GauriK58/5-bit-Parallel-Prefix-Adder/media/FPGA2.jpg

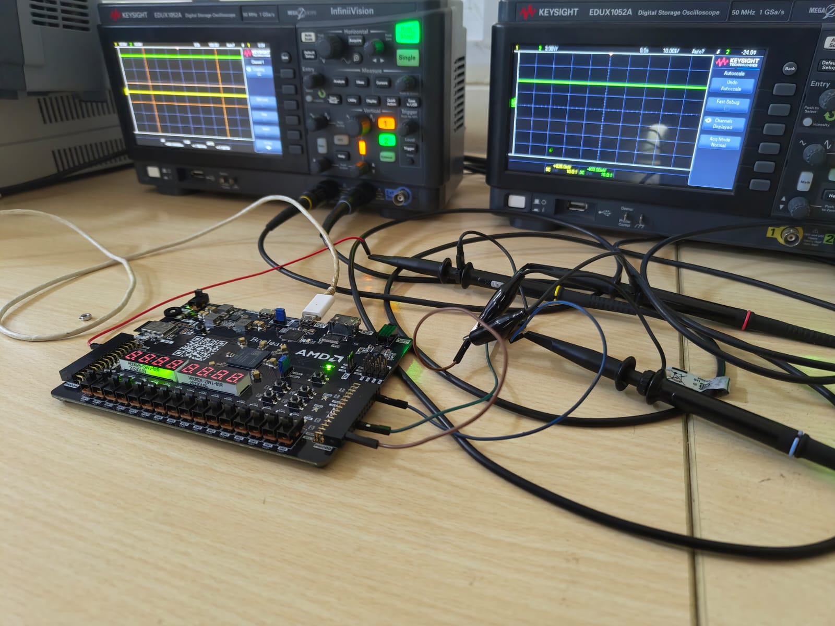
media/FPGA2.jpg
