GauriK58/5-bit-Parallel-Prefix-Adder/media/FPGA1.jpg

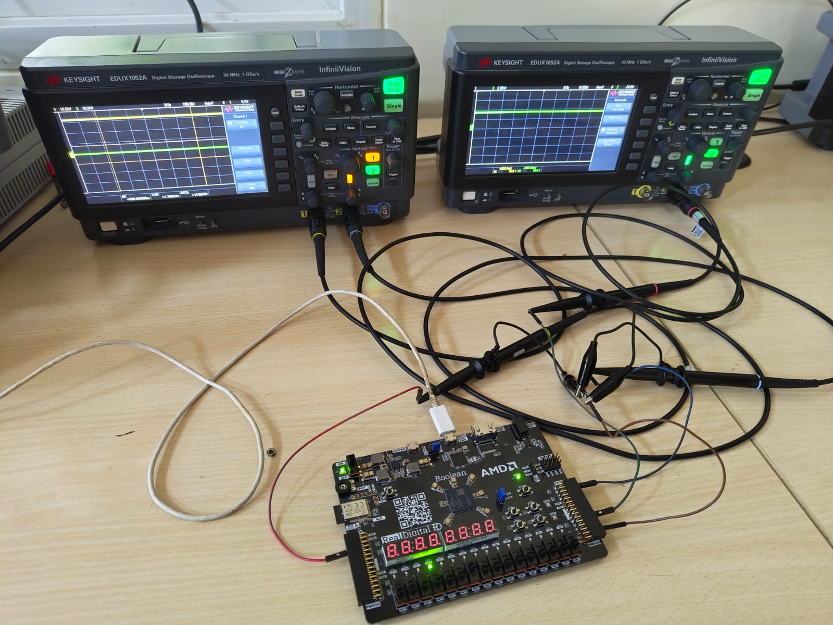
media/FPGA1.jpg
