GauriK58/5-bit-Parallel-Prefix-Adder/media/brentoperator.png

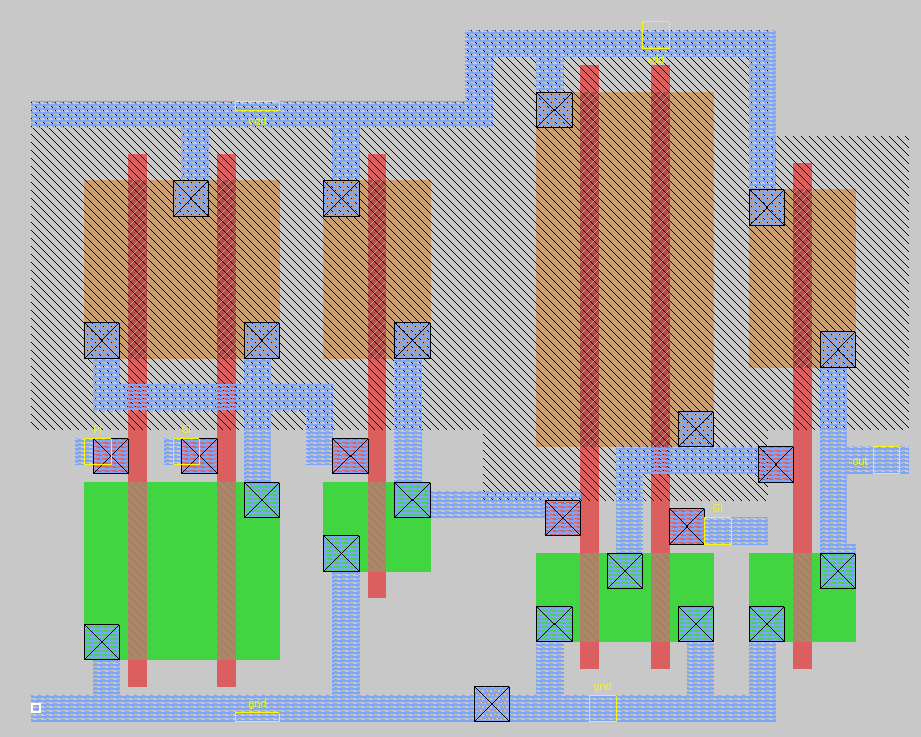
media/brentoperator.png
