GauriK58/5-bit-Parallel-Prefix-Adder/media/circuitdiagram.png

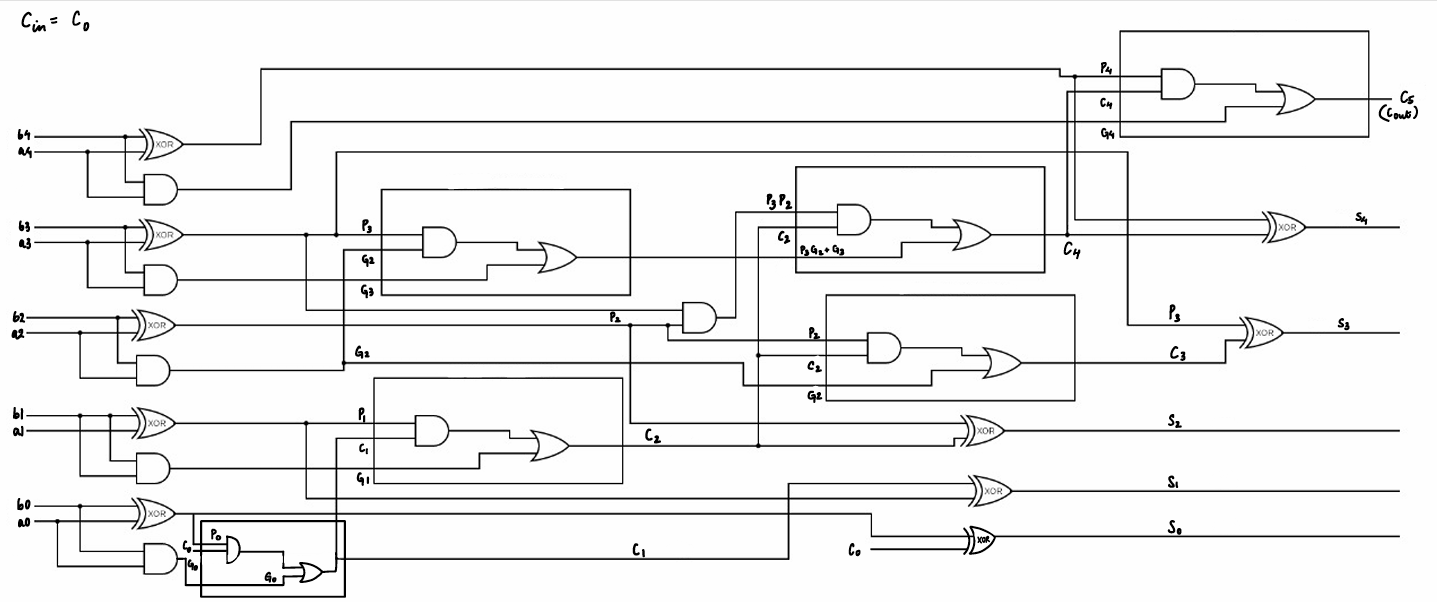
media/circuitdiagram.png
