GauriK58/5-bit-Parallel-Prefix-Adder/media/ip_op.png

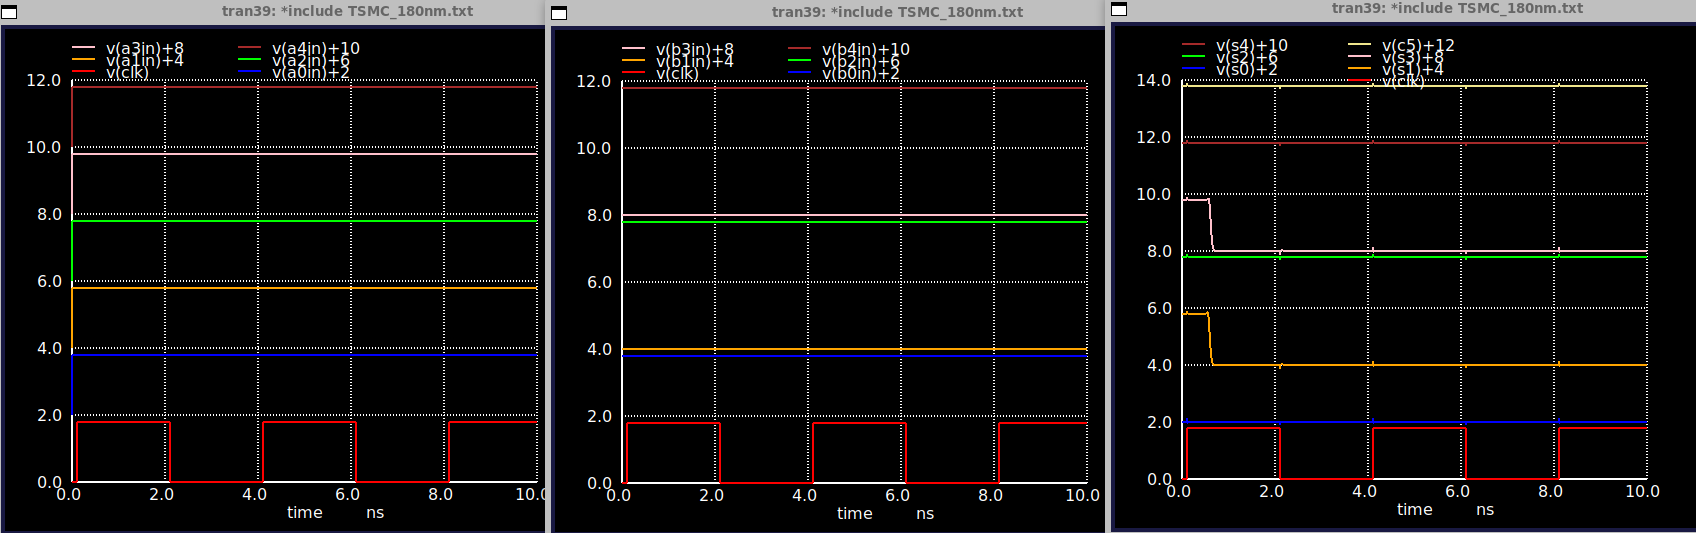
media/ip_op.png
