GauriK58/5-bit-Parallel-Prefix-Adder/media/ngspicepre1.png

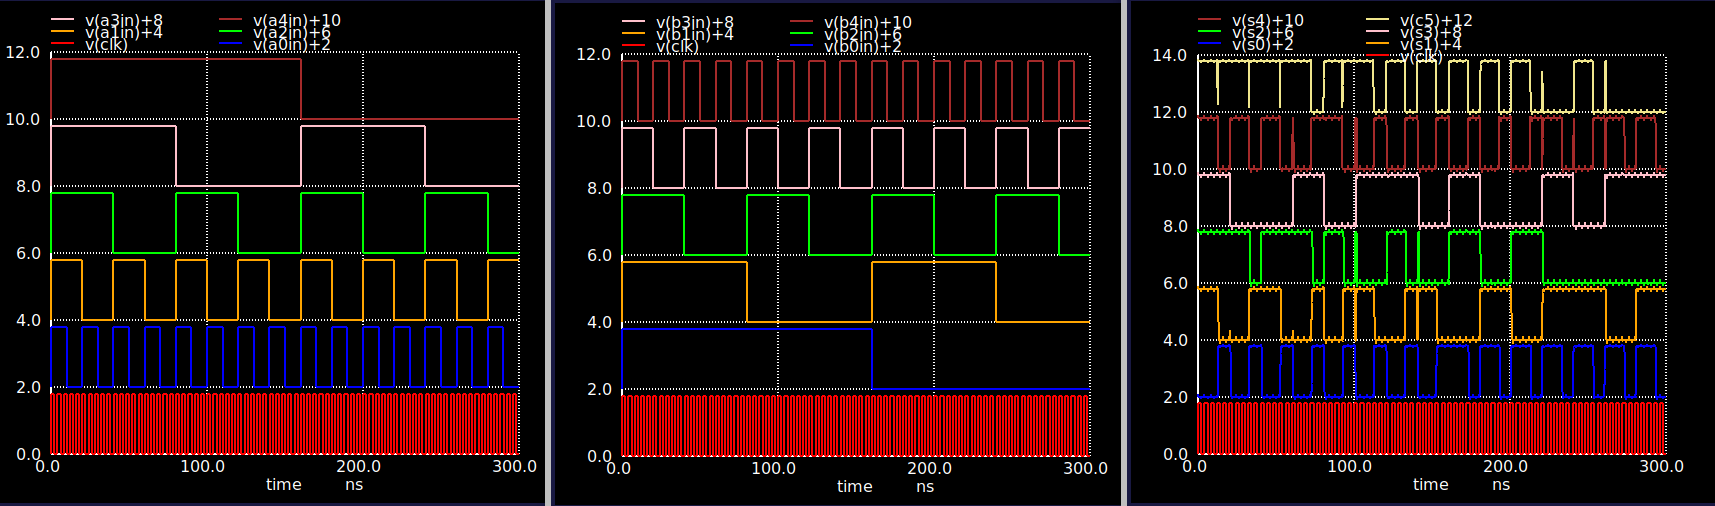
media/ngspicepre1.png
