GauriK58/5-bit-Parallel-Prefix-Adder/media/ngspicepre2.png

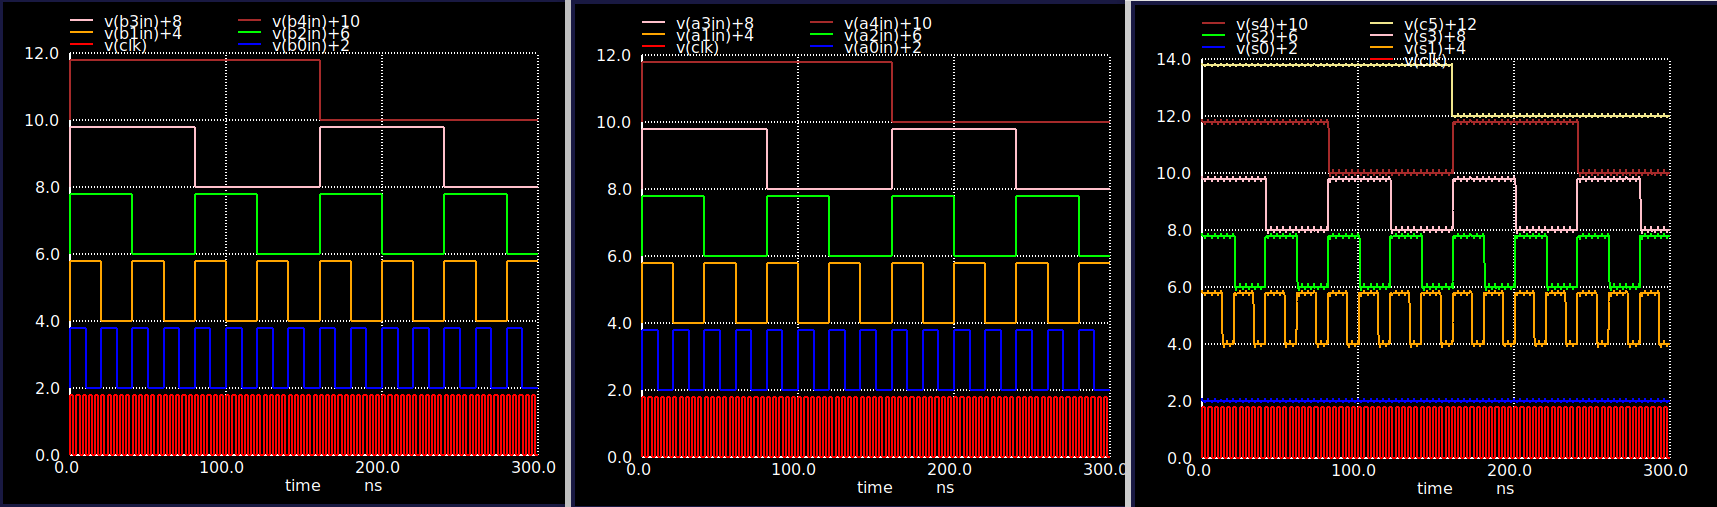
media/ngspicepre2.png
