GauriK58/5-bit-Parallel-Prefix-Adder/media/TSPC.png

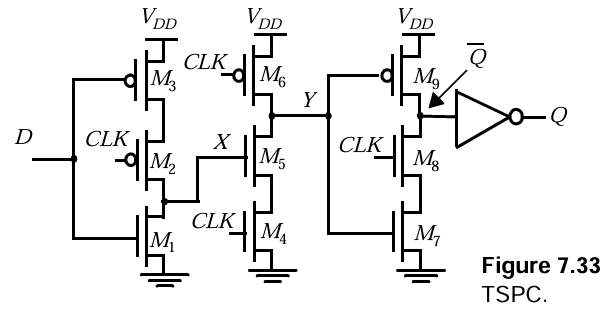
media/TSPC.png
