GauriK58/5-bit-Parallel-Prefix-Adder/ngspice/project_post.cir

.include TSMC_180nm.txt
.global gnd vdd

VDD vdd gnd dc 1.8V

* SPICE3 file created from project2.ext - technology: scmos

.option scale=0.09u

M1000 S2_ff a_536_362# VDD VDD CMOSP w=40 l=2
+  ad=200 pd=90 as=22922 ps=10400
M1001 b4 a_167_234# 0 0 CMOSN w=20 l=2
+  ad=100 pd=50 as=13032 ps=6526
M1002 a_306_571# a_296_604# a_306_519# VDD CMOSP w=32 l=2
+  ad=160 pd=74 as=192 ps=76
M1003 a_605_251# CLK VDD VDD CMOSP w=40 l=2
+  ad=200 pd=90 as=0 ps=0
M1004 0 G3 a_319_153# 0 CMOSN w=16 l=2
+  ad=0 pd=0 as=96 ps=44
M1005 0 CLK a_143_345# 0 CMOSN w=40 l=2
+  ad=0 pd=0 as=160 ps=88
M1006 a_13_419# a2_in 0 0 CMOSN w=20 l=2
+  ad=100 pd=50 as=0 ps=0
M1007 a_311_267# P3 0 0 CMOSN w=16 l=2
+  ad=96 pd=44 as=0 ps=0
M1008 a_505_512# CLK VDD VDD CMOSP w=40 l=2
+  ad=200 pd=90 as=0 ps=0
M1009 a_167_495# a_136_443# VDD VDD CMOSP w=40 l=2
+  ad=200 pd=90 as=0 ps=0
M1010 a_536_362# CLK a_536_414# 0 CMOSN w=40 l=2
+  ad=200 pd=90 as=160 ps=88
M1011 VDD P1 a_302_305# VDD CMOSP w=16 l=2
+  ad=0 pd=0 as=96 ps=44
M1012 a_43_443# a_13_419# a_36_443# 0 CMOSN w=40 l=2
+  ad=160 pd=88 as=200 ps=90
M1013 a_306_719# a_296_752# a_306_667# VDD CMOSP w=32 l=2
+  ad=160 pd=74 as=192 ps=76
M1014 a_306_719# G0 0 0 CMOSN w=8 l=2
+  ad=48 pd=28 as=0 ps=0
M1015 a_167_756# CLK a_167_704# 0 CMOSN w=40 l=2
+  ad=200 pd=90 as=160 ps=88
M1016 a_113_554# b1_in VDD VDD CMOSP w=80 l=2
+  ad=320 pd=168 as=0 ps=0
M1017 a_482_227# CLK a_482_263# VDD CMOSP w=80 l=2
+  ad=400 pd=170 as=320 ps=168
M1018 a_251_617# a_233_617# VDD VDD CMOSP w=16 l=2
+  ad=80 pd=42 as=0 ps=0
M1019 a_36_606# CLK VDD VDD CMOSP w=40 l=2
+  ad=200 pd=90 as=0 ps=0
M1020 a_536_251# a_505_251# 0 0 CMOSN w=40 l=2
+  ad=160 pd=88 as=0 ps=0
M1021 a_636_414# a_605_414# 0 0 CMOSN w=40 l=2
+  ad=160 pd=88 as=0 ps=0
M1022 0 a_360_99# a_370_66# 0 CMOSN w=8 l=2
+  ad=0 pd=0 as=48 ps=28
M1023 a_113_680# CLK a_113_716# VDD CMOSP w=80 l=2
+  ad=400 pd=170 as=320 ps=168
M1024 S4 a_414_553# 0 0 CMOSN w=8 l=2
+  ad=40 pd=26 as=0 ps=0
M1025 a_233_752# b0 a_208_752# 0 CMOSN w=8 l=2
+  ad=40 pd=26 as=80 ps=52
M1026 a4 a_67_234# VDD VDD CMOSP w=40 l=2
+  ad=280 pd=132 as=0 ps=0
M1027 S1_ff a_636_564# VDD VDD CMOSP w=40 l=2
+  ad=200 pd=90 as=0 ps=0
M1028 a_582_458# CLK a_582_362# VDD CMOSP w=80 l=2
+  ad=400 pd=170 as=320 ps=168
M1029 a_536_362# a_505_414# VDD VDD CMOSP w=40 l=2
+  ad=200 pd=90 as=0 ps=0
M1030 Cout_ff a_636_303# 0 0 CMOSN w=20 l=2
+  ad=100 pd=50 as=0 ps=0
M1031 VDD C1 a_366_337# VDD CMOSP w=17 l=2
+  ad=0 pd=0 as=102 ps=46
M1032 G2 a_226_411# VDD VDD CMOSP w=16 l=2
+  ad=80 pd=42 as=0 ps=0
M1033 a_396_752# a_378_752# VDD VDD CMOSP w=16 l=2
+  ad=80 pd=42 as=0 ps=0
M1034 a_113_419# b2_in 0 0 CMOSN w=20 l=2
+  ad=100 pd=50 as=0 ps=0
M1035 a_320_739# P0 a_301_749# 0 CMOSN w=16 l=2
+  ad=96 pd=44 as=80 ps=42
M1036 C4 a_370_214# 0 0 CMOSN w=8 l=2
+  ad=40 pd=26 as=0 ps=0
M1037 a_301_453# P2 VDD VDD CMOSP w=17 l=2
+  ad=102 pd=46 as=0 ps=0
M1038 C3 a_371_378# VDD VDD CMOSP w=16 l=2
+  ad=80 pd=42 as=0 ps=0
M1039 VDD a_302_305# P21 VDD CMOSP w=16 l=2
+  ad=0 pd=0 as=80 ps=42
M1040 a_689_299# Cout_ff a_680_388# w_676_315# CMOSP w=20 l=2
+  ad=100 pd=50 as=300 ps=150
M1041 a_143_443# a_113_419# a_136_443# 0 CMOSN w=40 l=2
+  ad=160 pd=88 as=200 ps=90
M1042 a_687_492# S0_ff VDD w_674_455# CMOSP w=20 l=2
+  ad=100 pd=50 as=0 ps=0
M1043 a_67_495# CLK a_67_443# 0 CMOSN w=40 l=2
+  ad=200 pd=90 as=160 ps=88
M1044 a_13_293# a3_in VDD VDD CMOSP w=80 l=2
+  ad=320 pd=168 as=0 ps=0
M1045 a_233_482# b2 a2 VDD CMOSP w=16 l=2
+  ad=80 pd=42 as=280 ps=132
M1046 VDD a2 a_226_411# VDD CMOSP w=16 l=2
+  ad=0 pd=0 as=96 ps=44
M1047 0 CLK a_512_251# 0 CMOSN w=40 l=2
+  ad=0 pd=0 as=160 ps=88
M1048 0 CLK a_612_414# 0 CMOSN w=40 l=2
+  ad=0 pd=0 as=160 ps=88
M1049 a_13_419# CLK a_13_455# VDD CMOSP w=80 l=2
+  ad=400 pd=170 as=320 ps=168
M1050 0 a_360_247# a_370_214# 0 CMOSN w=8 l=2
+  ad=0 pd=0 as=48 ps=28
M1051 a_136_606# CLK VDD VDD CMOSP w=40 l=2
+  ad=200 pd=90 as=0 ps=0
M1052 VDD a_301_453# a_296_456# VDD CMOSP w=17 l=2
+  ad=0 pd=0 as=85 ps=44
M1053 S0_ff a_536_564# 0 0 CMOSN w=20 l=2
+  ad=100 pd=50 as=0 ps=0
M1054 a_414_553# a_396_553# 0 0 CMOSN w=8 l=2
+  ad=40 pd=26 as=0 ps=0
M1055 a_687_439# S2_ff a_680_388# 0 CMOSN w=10 l=2
+  ad=50 pd=30 as=300 ps=180
M1056 0 a0 a_208_752# 0 CMOSN w=8 l=2
+  ad=0 pd=0 as=0 ps=0
M1057 a_67_234# a_36_182# VDD VDD CMOSP w=40 l=2
+  ad=200 pd=90 as=0 ps=0
M1058 a_636_564# a_605_512# VDD VDD CMOSP w=40 l=2
+  ad=200 pd=90 as=0 ps=0
M1059 a_300_163# P4 VDD VDD CMOSP w=17 l=2
+  ad=102 pd=46 as=0 ps=0
M1060 a_582_524# S1 VDD VDD CMOSP w=80 l=2
+  ad=320 pd=168 as=0 ps=0
M1061 b4 a_167_234# VDD VDD CMOSP w=40 l=2
+  ad=200 pd=90 as=0 ps=0
M1062 S3 a_407_622# VDD VDD CMOSP w=16 l=2
+  ad=80 pd=42 as=0 ps=0
M1063 G4 a_226_147# 0 0 CMOSN w=8 l=2
+  ad=40 pd=26 as=0 ps=0
M1064 a_226_448# b2 0 0 CMOSN w=16 l=2
+  ad=96 pd=44 as=0 ps=0
M1065 0 a_366_337# a_361_345# 0 CMOSN w=8 l=2
+  ad=0 pd=0 as=40 ps=26
M1066 a_378_752# C1 P1 VDD CMOSP w=16 l=2
+  ad=80 pd=42 as=160 ps=84
M1067 a_13_158# a4_in 0 0 CMOSN w=20 l=2
+  ad=100 pd=50 as=0 ps=0
M1068 S2_ff a_536_362# 0 0 CMOSN w=20 l=2
+  ad=100 pd=50 as=0 ps=0
M1069 a_371_378# a_361_345# a_371_406# VDD CMOSP w=32 l=2
+  ad=160 pd=74 as=192 ps=76
M1070 VDD a_300_163# a_295_166# VDD CMOSP w=17 l=2
+  ad=0 pd=0 as=85 ps=44
M1071 a_226_681# a0 a_226_718# 0 CMOSN w=16 l=2
+  ad=80 pd=42 as=96 ps=44
M1072 P4 a_251_218# 0 0 CMOSN w=8 l=2
+  ad=40 pd=26 as=0 ps=0
M1073 a_43_182# a_13_158# a_36_182# 0 CMOSN w=40 l=2
+  ad=160 pd=88 as=200 ps=90
M1074 C1 a_306_719# 0 0 CMOSN w=8 l=2
+  ad=40 pd=26 as=0 ps=0
M1075 VDD a2 a_208_482# VDD CMOSP w=16 l=2
+  ad=0 pd=0 as=80 ps=42
M1076 a_311_230# P4 a_311_267# 0 CMOSN w=16 l=2
+  ad=80 pd=42 as=0 ps=0
M1077 a_687_388# S3_ff a_680_388# 0 CMOSN w=10 l=2
+  ad=50 pd=30 as=0 ps=0
M1078 a_167_495# CLK a_167_443# 0 CMOSN w=40 l=2
+  ad=200 pd=90 as=160 ps=88
M1079 S2 a_404_687# 0 0 CMOSN w=8 l=2
+  ad=40 pd=26 as=0 ps=0
M1080 a_113_293# b3_in VDD VDD CMOSP w=80 l=2
+  ad=320 pd=168 as=0 ps=0
M1081 P3 a_251_350# VDD VDD CMOSP w=16 l=2
+  ad=160 pd=84 as=0 ps=0
M1082 a_67_704# a_36_704# 0 0 CMOSN w=40 l=2
+  ad=160 pd=88 as=0 ps=0
M1083 a_233_218# b4 a4 VDD CMOSP w=16 l=2
+  ad=80 pd=42 as=0 ps=0
M1084 a_36_345# CLK VDD VDD CMOSP w=40 l=2
+  ad=200 pd=90 as=0 ps=0
M1085 a_113_419# CLK a_113_455# VDD CMOSP w=80 l=2
+  ad=400 pd=170 as=320 ps=168
M1086 a_167_234# a_136_182# VDD VDD CMOSP w=40 l=2
+  ad=200 pd=90 as=0 ps=0
M1087 a_505_251# CLK VDD VDD CMOSP w=40 l=2
+  ad=200 pd=90 as=0 ps=0
M1088 a_233_482# b2 a_208_482# 0 CMOSN w=8 l=2
+  ad=40 pd=26 as=80 ps=52
M1089 a_407_622# a_389_622# VDD VDD CMOSP w=16 l=2
+  ad=80 pd=42 as=0 ps=0
M1090 a_384_234# P3 a_365_244# 0 CMOSN w=16 l=2
+  ad=96 pd=44 as=80 ps=42
M1091 0 a_296_752# a_306_719# 0 CMOSN w=8 l=2
+  ad=0 pd=0 as=0 ps=0
M1092 a_612_512# a_582_488# a_605_512# 0 CMOSN w=40 l=2
+  ad=160 pd=88 as=200 ps=90
M1093 a_396_752# a_378_752# 0 0 CMOSN w=8 l=2
+  ad=40 pd=26 as=0 ps=0
M1094 a_226_147# b4 VDD VDD CMOSP w=16 l=2
+  ad=96 pd=44 as=0 ps=0
M1095 a_43_606# a_13_650# a_36_606# 0 CMOSN w=40 l=2
+  ad=160 pd=88 as=200 ps=90
M1096 VDD P1 a_353_752# VDD CMOSP w=16 l=2
+  ad=0 pd=0 as=80 ps=42
M1097 a_226_184# b4 0 0 CMOSN w=16 l=2
+  ad=96 pd=44 as=0 ps=0
M1098 a_113_158# b4_in 0 0 CMOSN w=20 l=2
+  ad=100 pd=50 as=0 ps=0
M1099 S4 a_414_553# VDD VDD CMOSP w=16 l=2
+  ad=80 pd=42 as=0 ps=0
M1100 0 a_365_96# a_360_99# 0 CMOSN w=8 l=2
+  ad=0 pd=0 as=40 ps=26
M1101 a_251_218# a_233_218# 0 0 CMOSN w=8 l=2
+  ad=40 pd=26 as=0 ps=0
M1102 Cout_ff a_636_303# VDD VDD CMOSP w=40 l=2
+  ad=200 pd=90 as=0 ps=0
M1103 a_143_182# a_113_158# a_136_182# 0 CMOSN w=40 l=2
+  ad=160 pd=88 as=200 ps=90
M1104 a_305_133# a_295_166# a_305_81# VDD CMOSP w=32 l=2
+  ad=160 pd=74 as=192 ps=76
M1105 a_536_414# a_505_414# 0 0 CMOSN w=40 l=2
+  ad=0 pd=0 as=0 ps=0
M1106 a_67_234# CLK a_67_182# 0 CMOSN w=40 l=2
+  ad=200 pd=90 as=160 ps=88
M1107 0 a_302_305# P21 0 CMOSN w=8 l=2
+  ad=0 pd=0 as=40 ps=26
M1108 a_404_687# a_386_687# 0 0 CMOSN w=8 l=2
+  ad=40 pd=26 as=0 ps=0
M1109 a_251_350# a_233_350# VDD VDD CMOSP w=16 l=2
+  ad=80 pd=42 as=0 ps=0
M1110 S0_ff a_536_564# VDD VDD CMOSP w=40 l=2
+  ad=200 pd=90 as=0 ps=0
M1111 0 CLK a_43_704# 0 CMOSN w=40 l=2
+  ad=0 pd=0 as=160 ps=88
M1112 0 0 a_320_739# 0 CMOSN w=16 l=2
+  ad=0 pd=0 as=0 ps=0
M1113 VDD G1 a_301_453# VDD CMOSP w=17 l=2
+  ad=0 pd=0 as=0 ps=0
M1114 a_167_704# a_136_704# 0 0 CMOSN w=40 l=2
+  ad=0 pd=0 as=0 ps=0
M1115 VDD a4 a_208_218# VDD CMOSP w=16 l=2
+  ad=0 pd=0 as=80 ps=42
M1116 G34 a_305_133# VDD VDD CMOSP w=16 l=2
+  ad=80 pd=42 as=0 ps=0
M1117 a_482_458# CLK a_482_362# VDD CMOSP w=80 l=2
+  ad=400 pd=170 as=320 ps=168
M1118 a_13_158# CLK a_13_194# VDD CMOSP w=80 l=2
+  ad=400 pd=170 as=320 ps=168
M1119 S4_ff a_536_303# 0 0 CMOSN w=20 l=2
+  ad=100 pd=50 as=0 ps=0
M1120 a_136_345# CLK VDD VDD CMOSP w=40 l=2
+  ad=200 pd=90 as=0 ps=0
M1121 S3 a_407_622# 0 0 CMOSN w=8 l=2
+  ad=40 pd=26 as=0 ps=0
M1122 0 a2 a_208_482# 0 CMOSN w=8 l=2
+  ad=0 pd=0 as=0 ps=0
M1123 G1 a_226_546# 0 0 CMOSN w=8 l=2
+  ad=40 pd=26 as=0 ps=0
M1124 a_582_263# Cout VDD VDD CMOSP w=80 l=2
+  ad=320 pd=168 as=0 ps=0
M1125 a_687_544# S1_ff a_680_388# 0 CMOSN w=10 l=2
+  ad=50 pd=30 as=0 ps=0
M1126 a1 a_67_554# VDD VDD CMOSP w=40 l=2
+  ad=280 pd=132 as=0 ps=0
M1127 a_378_752# C1 a_353_752# 0 CMOSN w=8 l=2
+  ad=40 pd=26 as=80 ps=52
M1128 a_636_564# CLK a_636_512# 0 CMOSN w=40 l=2
+  ad=200 pd=90 as=160 ps=88
M1129 a_687_439# S2_ff VDD w_674_455# CMOSP w=20 l=2
+  ad=100 pd=50 as=0 ps=0
M1130 a_143_606# a_113_650# a_136_606# 0 CMOSN w=40 l=2
+  ad=160 pd=88 as=200 ps=90
M1131 a_582_458# S3 0 0 CMOSN w=20 l=2
+  ad=100 pd=50 as=0 ps=0
M1132 a_414_553# a_396_553# VDD VDD CMOSP w=16 l=2
+  ad=80 pd=42 as=0 ps=0
M1133 P1 a_251_617# 0 0 CMOSN w=8 l=2
+  ad=40 pd=26 as=0 ps=0
M1134 a_67_554# CLK a_67_606# 0 CMOSN w=40 l=2
+  ad=200 pd=90 as=160 ps=88
M1135 a_36_704# CLK VDD VDD CMOSP w=40 l=2
+  ad=200 pd=90 as=0 ps=0
M1136 VDD G3 a_300_163# VDD CMOSP w=17 l=2
+  ad=0 pd=0 as=0 ps=0
M1137 0 CLK a_512_414# 0 CMOSN w=40 l=2
+  ad=0 pd=0 as=160 ps=88
M1138 a_636_303# a_605_251# VDD VDD CMOSP w=40 l=2
+  ad=200 pd=90 as=0 ps=0
M1139 a_226_411# a2 a_226_448# 0 CMOSN w=16 l=2
+  ad=80 pd=42 as=0 ps=0
M1140 P3 a_251_350# 0 0 CMOSN w=8 l=2
+  ad=40 pd=26 as=0 ps=0
M1141 S2 a_404_687# VDD VDD CMOSP w=16 l=2
+  ad=80 pd=42 as=0 ps=0
M1142 a_233_617# b1 a1 VDD CMOSP w=16 l=2
+  ad=80 pd=42 as=0 ps=0
M1143 a_321_295# P2 a_302_305# 0 CMOSN w=16 l=2
+  ad=96 pd=44 as=80 ps=42
M1144 a_536_564# a_505_512# VDD VDD CMOSP w=40 l=2
+  ad=200 pd=90 as=0 ps=0
M1145 a_167_234# CLK a_167_182# 0 CMOSN w=40 l=2
+  ad=200 pd=90 as=160 ps=88
M1146 a_482_524# P0 VDD VDD CMOSP w=80 l=2
+  ad=320 pd=168 as=0 ps=0
M1147 a_67_443# a_36_443# 0 0 CMOSN w=40 l=2
+  ad=0 pd=0 as=0 ps=0
M1148 G3 a_226_279# 0 0 CMOSN w=8 l=2
+  ad=40 pd=26 as=0 ps=0
M1149 0 CLK a_143_704# 0 CMOSN w=40 l=2
+  ad=0 pd=0 as=160 ps=88
M1150 a_407_622# a_389_622# 0 0 CMOSN w=8 l=2
+  ad=40 pd=26 as=0 ps=0
M1151 a_13_650# CLK a_13_554# VDD CMOSP w=80 l=2
+  ad=400 pd=170 as=320 ps=168
M1152 a_113_158# CLK a_113_194# VDD CMOSP w=80 l=2
+  ad=400 pd=170 as=320 ps=168
M1153 a_226_546# b1 VDD VDD CMOSP w=16 l=2
+  ad=96 pd=44 as=0 ps=0
M1154 a_301_601# P1 VDD VDD CMOSP w=17 l=2
+  ad=102 pd=46 as=0 ps=0
M1155 a_67_554# a_36_606# VDD VDD CMOSP w=40 l=2
+  ad=200 pd=90 as=0 ps=0
M1156 a_612_251# a_582_227# a_605_251# 0 CMOSN w=40 l=2
+  ad=160 pd=88 as=200 ps=90
M1157 G4 a_226_147# VDD VDD CMOSP w=16 l=2
+  ad=80 pd=42 as=0 ps=0
M1158 0 P1 a_353_752# 0 CMOSN w=8 l=2
+  ad=0 pd=0 as=0 ps=0
M1159 a_226_583# b1 0 0 CMOSN w=16 l=2
+  ad=96 pd=44 as=0 ps=0
M1160 a_582_488# S1 0 0 CMOSN w=20 l=2
+  ad=100 pd=50 as=0 ps=0
M1161 b1 a_167_554# VDD VDD CMOSP w=40 l=2
+  ad=200 pd=90 as=0 ps=0
M1162 a_43_345# a_13_389# a_36_345# 0 CMOSN w=40 l=2
+  ad=160 pd=88 as=200 ps=90
M1163 a_251_617# a_233_617# 0 0 CMOSN w=8 l=2
+  ad=40 pd=26 as=0 ps=0
M1164 a_605_414# CLK VDD VDD CMOSP w=40 l=2
+  ad=200 pd=90 as=0 ps=0
M1165 a_136_704# CLK VDD VDD CMOSP w=40 l=2
+  ad=200 pd=90 as=0 ps=0
M1166 a_167_554# CLK a_167_606# 0 CMOSN w=40 l=2
+  ad=200 pd=90 as=160 ps=88
M1167 a_13_650# a1_in 0 0 CMOSN w=20 l=2
+  ad=100 pd=50 as=0 ps=0
M1168 0 C3 a_384_234# 0 CMOSN w=16 l=2
+  ad=0 pd=0 as=0 ps=0
M1169 a_301_749# P0 VDD VDD CMOSP w=17 l=2
+  ad=102 pd=46 as=0 ps=0
M1170 P0 a_251_752# VDD VDD CMOSP w=16 l=2
+  ad=80 pd=42 as=0 ps=0
M1171 a_384_86# P34 a_365_96# 0 CMOSN w=16 l=2
+  ad=96 pd=44 as=80 ps=42
M1172 VDD a_301_601# a_296_604# VDD CMOSP w=17 l=2
+  ad=0 pd=0 as=85 ps=44
M1173 a_689_247# S4_ff a_680_388# 0 CMOSN w=10 l=2
+  ad=50 pd=30 as=0 ps=0
M1174 VDD a4 a_226_147# VDD CMOSP w=16 l=2
+  ad=0 pd=0 as=0 ps=0
M1175 a_251_350# a_233_350# 0 0 CMOSN w=8 l=2
+  ad=40 pd=26 as=0 ps=0
M1176 a_404_687# a_386_687# VDD VDD CMOSP w=16 l=2
+  ad=80 pd=42 as=0 ps=0
M1177 VDD a1 a_208_617# VDD CMOSP w=16 l=2
+  ad=0 pd=0 as=80 ps=42
M1178 a_226_147# a4 a_226_184# 0 CMOSN w=16 l=2
+  ad=80 pd=42 as=0 ps=0
M1179 a_396_553# C4 a_371_553# 0 CMOSN w=8 l=2
+  ad=40 pd=26 as=80 ps=52
M1180 0 CLK a_43_443# 0 CMOSN w=40 l=2
+  ad=0 pd=0 as=0 ps=0
M1181 a_167_443# a_136_443# 0 0 CMOSN w=40 l=2
+  ad=0 pd=0 as=0 ps=0
M1182 a_512_512# a_482_488# a_505_512# 0 CMOSN w=40 l=2
+  ad=160 pd=88 as=200 ps=90
M1183 a0 a_67_756# 0 0 CMOSN w=20 l=2
+  ad=100 pd=50 as=0 ps=0
M1184 a_13_716# a0_in VDD VDD CMOSP w=80 l=2
+  ad=320 pd=168 as=0 ps=0
M1185 a_370_14# G34 VDD VDD CMOSP w=32 l=2
+  ad=192 pd=76 as=0 ps=0
M1186 VDD a_301_749# a_296_752# VDD CMOSP w=17 l=2
+  ad=0 pd=0 as=85 ps=44
M1187 a_113_650# CLK a_113_554# VDD CMOSP w=80 l=2
+  ad=400 pd=170 as=0 ps=0
M1188 a3 a_67_293# VDD VDD CMOSP w=40 l=2
+  ad=280 pd=132 as=0 ps=0
M1189 C2 a_306_571# VDD VDD CMOSP w=16 l=2
+  ad=80 pd=42 as=0 ps=0
M1190 a_167_554# a_136_606# VDD VDD CMOSP w=40 l=2
+  ad=200 pd=90 as=0 ps=0
M1191 a_636_303# CLK a_636_251# 0 CMOSN w=40 l=2
+  ad=200 pd=90 as=160 ps=88
M1192 a1 a_67_554# 0 0 CMOSN w=20 l=2
+  ad=100 pd=50 as=0 ps=0
M1193 a_13_680# a0_in 0 0 CMOSN w=20 l=2
+  ad=100 pd=50 as=0 ps=0
M1194 S4_ff a_536_303# VDD VDD CMOSP w=40 l=2
+  ad=200 pd=90 as=0 ps=0
M1195 a_143_345# a_113_389# a_136_345# 0 CMOSN w=40 l=2
+  ad=0 pd=0 as=200 ps=90
M1196 a_36_443# CLK VDD VDD CMOSP w=40 l=2
+  ad=200 pd=90 as=0 ps=0
M1197 a_67_293# CLK a_67_345# 0 CMOSN w=40 l=2
+  ad=200 pd=90 as=160 ps=88
M1198 a_251_752# a_233_752# VDD VDD CMOSP w=16 l=2
+  ad=80 pd=42 as=0 ps=0
M1199 a_113_650# b1_in 0 0 CMOSN w=20 l=2
+  ad=100 pd=50 as=0 ps=0
M1200 C1 a_306_719# VDD VDD CMOSP w=16 l=2
+  ad=80 pd=42 as=0 ps=0
M1201 a_371_378# G21 0 0 CMOSN w=8 l=2
+  ad=48 pd=28 as=0 ps=0
M1202 a_385_350# P21 a_366_337# 0 CMOSN w=16 l=2
+  ad=96 pd=44 as=80 ps=42
M1203 0 P4 a_371_553# 0 CMOSN w=8 l=2
+  ad=0 pd=0 as=0 ps=0
M1204 a_482_263# S4 VDD VDD CMOSP w=80 l=2
+  ad=0 pd=0 as=0 ps=0
M1205 a_365_96# P34 VDD VDD CMOSP w=17 l=2
+  ad=102 pd=46 as=0 ps=0
M1206 a_67_182# a_36_182# 0 0 CMOSN w=40 l=2
+  ad=0 pd=0 as=0 ps=0
M1207 0 CLK a_143_443# 0 CMOSN w=40 l=2
+  ad=0 pd=0 as=0 ps=0
M1208 a_389_622# C3 P3 VDD CMOSP w=16 l=2
+  ad=80 pd=42 as=0 ps=0
M1209 b0 a_167_756# 0 0 CMOSN w=20 l=2
+  ad=100 pd=50 as=0 ps=0
M1210 a_113_716# b0_in VDD VDD CMOSP w=80 l=2
+  ad=0 pd=0 as=0 ps=0
M1211 a_13_389# CLK a_13_293# VDD CMOSP w=80 l=2
+  ad=400 pd=170 as=0 ps=0
M1212 G1 a_226_546# VDD VDD CMOSP w=16 l=2
+  ad=80 pd=42 as=0 ps=0
M1213 0 a_301_453# a_296_456# 0 CMOSN w=8 l=2
+  ad=0 pd=0 as=40 ps=26
M1214 a_536_564# CLK a_536_512# 0 CMOSN w=40 l=2
+  ad=200 pd=90 as=160 ps=88
M1215 a_482_458# S2 0 0 CMOSN w=20 l=2
+  ad=100 pd=50 as=0 ps=0
M1216 a_582_362# S3 VDD VDD CMOSP w=80 l=2
+  ad=0 pd=0 as=0 ps=0
M1217 0 P1 a_321_295# 0 CMOSN w=16 l=2
+  ad=0 pd=0 as=0 ps=0
M1218 a_67_293# a_36_345# VDD VDD CMOSP w=40 l=2
+  ad=200 pd=90 as=0 ps=0
M1219 a_365_244# P3 VDD VDD CMOSP w=17 l=2
+  ad=102 pd=46 as=0 ps=0
M1220 b3 a_167_293# VDD VDD CMOSP w=40 l=2
+  ad=200 pd=90 as=0 ps=0
M1221 Cout a_370_66# 0 0 CMOSN w=8 l=2
+  ad=40 pd=26 as=0 ps=0
M1222 a_582_488# CLK a_582_524# VDD CMOSP w=80 l=2
+  ad=400 pd=170 as=0 ps=0
M1223 a_536_303# a_505_251# VDD VDD CMOSP w=40 l=2
+  ad=200 pd=90 as=0 ps=0
M1224 VDD a_365_96# a_360_99# VDD CMOSP w=17 l=2
+  ad=0 pd=0 as=85 ps=44
M1225 a_687_388# S3_ff a_680_388# w_674_382# CMOSP w=20 l=2
+  ad=100 pd=50 as=0 ps=0
M1226 b1 a_167_554# 0 0 CMOSN w=20 l=2
+  ad=100 pd=50 as=0 ps=0
M1227 a_113_680# b0_in 0 0 CMOSN w=20 l=2
+  ad=100 pd=50 as=0 ps=0
M1228 a_636_512# a_605_512# 0 0 CMOSN w=40 l=2
+  ad=0 pd=0 as=0 ps=0
M1229 P0 a_251_752# 0 0 CMOSN w=8 l=2
+  ad=40 pd=26 as=0 ps=0
M1230 Cout a_370_66# VDD VDD CMOSP w=16 l=2
+  ad=80 pd=42 as=0 ps=0
M1231 a_233_218# b4 a_208_218# 0 CMOSN w=8 l=2
+  ad=40 pd=26 as=80 ps=52
M1232 a_136_443# CLK VDD VDD CMOSP w=40 l=2
+  ad=200 pd=90 as=0 ps=0
M1233 a_167_293# CLK a_167_345# 0 CMOSN w=40 l=2
+  ad=200 pd=90 as=160 ps=88
M1234 VDD a1 a_226_546# VDD CMOSP w=16 l=2
+  ad=0 pd=0 as=0 ps=0
M1235 VDD C1 a_301_601# VDD CMOSP w=17 l=2
+  ad=0 pd=0 as=0 ps=0
M1236 a_67_606# a_36_606# 0 0 CMOSN w=40 l=2
+  ad=0 pd=0 as=0 ps=0
M1237 a_386_687# C2 a_361_687# 0 CMOSN w=8 l=2
+  ad=40 pd=26 as=80 ps=52
M1238 G0 a_226_681# 0 0 CMOSN w=8 l=2
+  ad=40 pd=26 as=0 ps=0
M1239 a_226_546# a1 a_226_583# 0 CMOSN w=16 l=2
+  ad=80 pd=42 as=0 ps=0
M1240 0 a_300_163# a_295_166# 0 CMOSN w=8 l=2
+  ad=0 pd=0 as=40 ps=26
M1241 a_233_350# b3 a3 VDD CMOSP w=16 l=2
+  ad=80 pd=42 as=0 ps=0
M1242 a0 a_67_756# VDD VDD CMOSP w=40 l=2
+  ad=280 pd=132 as=0 ps=0
M1243 VDD a_365_244# a_360_247# VDD CMOSP w=17 l=2
+  ad=0 pd=0 as=85 ps=44
M1244 a_582_227# Cout 0 0 CMOSN w=20 l=2
+  ad=100 pd=50 as=0 ps=0
M1245 a_370_66# G34 0 0 CMOSN w=8 l=2
+  ad=0 pd=0 as=0 ps=0
M1246 0 CLK a_43_182# 0 CMOSN w=40 l=2
+  ad=0 pd=0 as=0 ps=0
M1247 VDD P3 a_364_622# VDD CMOSP w=16 l=2
+  ad=0 pd=0 as=80 ps=42
M1248 a_512_251# a_482_227# a_505_251# 0 CMOSN w=40 l=2
+  ad=0 pd=0 as=200 ps=90
M1249 a_167_182# a_136_182# 0 0 CMOSN w=40 l=2
+  ad=0 pd=0 as=0 ps=0
M1250 a_612_414# a_582_458# a_605_414# 0 CMOSN w=40 l=2
+  ad=0 pd=0 as=200 ps=90
M1251 a2 a_67_495# 0 0 CMOSN w=20 l=2
+  ad=100 pd=50 as=0 ps=0
M1252 a_306_423# G2 0 0 CMOSN w=8 l=2
+  ad=48 pd=28 as=0 ps=0
M1253 VDD 0 a_301_749# VDD CMOSP w=17 l=2
+  ad=0 pd=0 as=0 ps=0
M1254 a_482_488# P0 0 0 CMOSN w=20 l=2
+  ad=100 pd=50 as=0 ps=0
M1255 a_13_455# a2_in VDD VDD CMOSP w=80 l=2
+  ad=0 pd=0 as=0 ps=0
M1256 0 a_301_601# a_296_604# 0 CMOSN w=8 l=2
+  ad=0 pd=0 as=40 ps=26
M1257 a_113_389# CLK a_113_293# VDD CMOSP w=80 l=2
+  ad=400 pd=170 as=0 ps=0
M1258 a_226_279# b3 VDD VDD CMOSP w=16 l=2
+  ad=96 pd=44 as=0 ps=0
M1259 a_226_681# b0 VDD VDD CMOSP w=16 l=2
+  ad=96 pd=44 as=0 ps=0
M1260 a_689_247# S4_ff a_680_388# w_676_240# CMOSP w=20 l=2
+  ad=100 pd=50 as=0 ps=0
M1261 C4 a_370_214# VDD VDD CMOSP w=16 l=2
+  ad=80 pd=42 as=0 ps=0
M1262 P2 a_251_482# VDD VDD CMOSP w=16 l=2
+  ad=160 pd=84 as=0 ps=0
M1263 a_167_293# a_136_345# VDD VDD CMOSP w=40 l=2
+  ad=200 pd=90 as=0 ps=0
M1264 a_396_553# C4 P4 VDD CMOSP w=16 l=2
+  ad=80 pd=42 as=160 ps=84
M1265 a_505_414# CLK VDD VDD CMOSP w=40 l=2
+  ad=200 pd=90 as=0 ps=0
M1266 a3 a_67_293# 0 0 CMOSN w=20 l=2
+  ad=100 pd=50 as=0 ps=0
M1267 a_306_571# G1 0 0 CMOSN w=8 l=2
+  ad=48 pd=28 as=0 ps=0
M1268 a_370_162# G3 VDD VDD CMOSP w=32 l=2
+  ad=192 pd=76 as=0 ps=0
M1269 0 CLK a_612_512# 0 CMOSN w=40 l=2
+  ad=0 pd=0 as=0 ps=0
M1270 0 a_301_749# a_296_752# 0 CMOSN w=8 l=2
+  ad=0 pd=0 as=40 ps=26
M1271 a_251_752# a_233_752# 0 0 CMOSN w=8 l=2
+  ad=40 pd=26 as=0 ps=0
M1272 0 a4 a_208_218# 0 CMOSN w=8 l=2
+  ad=0 pd=0 as=0 ps=0
M1273 a_305_133# G4 0 0 CMOSN w=8 l=2
+  ad=48 pd=28 as=0 ps=0
M1274 C3 a_371_378# 0 0 CMOSN w=8 l=2
+  ad=40 pd=26 as=0 ps=0
M1275 0 CLK a_43_606# 0 CMOSN w=40 l=2
+  ad=0 pd=0 as=0 ps=0
M1276 0 P2 a_361_687# 0 CMOSN w=8 l=2
+  ad=0 pd=0 as=0 ps=0
M1277 a_320_443# P2 a_301_453# 0 CMOSN w=16 l=2
+  ad=96 pd=44 as=80 ps=42
M1278 a_167_606# a_136_606# 0 0 CMOSN w=40 l=2
+  ad=0 pd=0 as=0 ps=0
M1279 VDD a3 a_208_350# VDD CMOSP w=16 l=2
+  ad=0 pd=0 as=80 ps=42
M1280 a_226_316# b3 0 0 CMOSN w=16 l=2
+  ad=96 pd=44 as=0 ps=0
M1281 a_67_756# a_36_704# VDD VDD CMOSP w=40 l=2
+  ad=200 pd=90 as=0 ps=0
M1282 G21 a_306_423# VDD VDD CMOSP w=17 l=2
+  ad=85 pd=44 as=0 ps=0
M1283 S3_ff a_636_362# VDD VDD CMOSP w=40 l=2
+  ad=200 pd=90 as=0 ps=0
M1284 a_389_622# C3 a_364_622# 0 CMOSN w=8 l=2
+  ad=40 pd=26 as=80 ps=52
M1285 b0 a_167_756# VDD VDD CMOSP w=40 l=2
+  ad=200 pd=90 as=0 ps=0
M1286 S1 a_396_752# VDD VDD CMOSP w=16 l=2
+  ad=80 pd=42 as=0 ps=0
M1287 a_311_230# P3 VDD VDD CMOSP w=16 l=2
+  ad=96 pd=44 as=0 ps=0
M1288 0 CLK a_143_182# 0 CMOSN w=40 l=2
+  ad=0 pd=0 as=0 ps=0
M1289 b2 a_167_495# 0 0 CMOSN w=20 l=2
+  ad=100 pd=50 as=0 ps=0
M1290 a_306_370# G2 VDD VDD CMOSP w=33 l=2
+  ad=198 pd=78 as=0 ps=0
M1291 a_113_455# b2_in VDD VDD CMOSP w=80 l=2
+  ad=0 pd=0 as=0 ps=0
M1292 a_320_591# P1 a_301_601# 0 CMOSN w=16 l=2
+  ad=96 pd=44 as=80 ps=42
M1293 0 a_361_345# a_371_378# 0 CMOSN w=8 l=2
+  ad=0 pd=0 as=0 ps=0
M1294 a_605_512# CLK VDD VDD CMOSP w=40 l=2
+  ad=200 pd=90 as=0 ps=0
M1295 a_36_182# CLK VDD VDD CMOSP w=40 l=2
+  ad=200 pd=90 as=0 ps=0
M1296 a_636_362# CLK a_636_414# 0 CMOSN w=40 l=2
+  ad=200 pd=90 as=0 ps=0
M1297 a_536_303# CLK a_536_251# 0 CMOSN w=40 l=2
+  ad=200 pd=90 as=0 ps=0
M1298 0 C1 a_385_350# 0 CMOSN w=16 l=2
+  ad=0 pd=0 as=0 ps=0
M1299 a_251_482# a_233_482# VDD VDD CMOSP w=16 l=2
+  ad=80 pd=42 as=0 ps=0
M1300 a_687_544# S1_ff VDD w_674_560# CMOSP w=20 l=2
+  ad=100 pd=50 as=0 ps=0
M1301 a_306_519# G1 VDD VDD CMOSP w=32 l=2
+  ad=0 pd=0 as=0 ps=0
M1302 VDD P4 a_371_553# VDD CMOSP w=16 l=2
+  ad=0 pd=0 as=80 ps=42
M1303 a_319_153# P4 a_300_163# 0 CMOSN w=16 l=2
+  ad=0 pd=0 as=80 ps=42
M1304 VDD C4 a_365_96# VDD CMOSP w=17 l=2
+  ad=0 pd=0 as=0 ps=0
M1305 P4 a_251_218# VDD VDD CMOSP w=16 l=2
+  ad=0 pd=0 as=0 ps=0
M1306 a_233_617# b1 a_208_617# 0 CMOSN w=8 l=2
+  ad=40 pd=26 as=80 ps=52
M1307 a_582_227# CLK a_582_263# VDD CMOSP w=80 l=2
+  ad=400 pd=170 as=0 ps=0
M1308 b3 a_167_293# 0 0 CMOSN w=20 l=2
+  ad=100 pd=50 as=0 ps=0
M1309 a_636_251# a_605_251# 0 0 CMOSN w=40 l=2
+  ad=0 pd=0 as=0 ps=0
M1310 a_302_305# P2 VDD VDD CMOSP w=16 l=2
+  ad=0 pd=0 as=0 ps=0
M1311 P2 a_251_482# 0 0 CMOSN w=8 l=2
+  ad=40 pd=26 as=0 ps=0
M1312 a_386_687# C2 P2 VDD CMOSP w=16 l=2
+  ad=80 pd=42 as=0 ps=0
M1313 a_233_350# b3 a_208_350# 0 CMOSN w=8 l=2
+  ad=40 pd=26 as=80 ps=52
M1314 a_67_345# a_36_345# 0 0 CMOSN w=40 l=2
+  ad=0 pd=0 as=0 ps=0
M1315 a_306_667# G0 VDD VDD CMOSP w=32 l=2
+  ad=0 pd=0 as=0 ps=0
M1316 0 CLK a_143_606# 0 CMOSN w=40 l=2
+  ad=0 pd=0 as=0 ps=0
M1317 G2 a_226_411# 0 0 CMOSN w=8 l=2
+  ad=40 pd=26 as=0 ps=0
M1318 VDD C3 a_365_244# VDD CMOSP w=17 l=2
+  ad=0 pd=0 as=0 ps=0
M1319 a_636_362# a_605_414# VDD VDD CMOSP w=40 l=2
+  ad=200 pd=90 as=0 ps=0
M1320 a2 a_67_495# VDD VDD CMOSP w=40 l=2
+  ad=0 pd=0 as=0 ps=0
M1321 0 P3 a_364_622# 0 CMOSN w=8 l=2
+  ad=0 pd=0 as=0 ps=0
M1322 a_167_756# a_136_704# VDD VDD CMOSP w=40 l=2
+  ad=200 pd=90 as=0 ps=0
M1323 a_43_704# a_13_680# a_36_704# 0 CMOSN w=40 l=2
+  ad=0 pd=0 as=200 ps=90
M1324 G21 a_306_423# 0 0 CMOSN w=8 l=2
+  ad=40 pd=26 as=0 ps=0
M1325 0 a_365_244# a_360_247# 0 CMOSN w=8 l=2
+  ad=0 pd=0 as=40 ps=26
M1326 a_482_362# S2 VDD VDD CMOSP w=80 l=2
+  ad=0 pd=0 as=0 ps=0
M1327 0 C4 a_384_86# 0 CMOSN w=16 l=2
+  ad=0 pd=0 as=0 ps=0
M1328 a_689_299# Cout_ff a_680_388# 0 CMOSN w=10 l=2
+  ad=50 pd=30 as=0 ps=0
M1329 a_13_194# a4_in VDD VDD CMOSP w=80 l=2
+  ad=0 pd=0 as=0 ps=0
M1330 G3 a_226_279# VDD VDD CMOSP w=16 l=2
+  ad=80 pd=42 as=0 ps=0
M1331 G0 a_226_681# VDD VDD CMOSP w=16 l=2
+  ad=80 pd=42 as=0 ps=0
M1332 a_482_488# CLK a_482_524# VDD CMOSP w=80 l=2
+  ad=400 pd=170 as=0 ps=0
M1333 a_136_182# CLK VDD VDD CMOSP w=40 l=2
+  ad=200 pd=90 as=0 ps=0
M1334 a_366_337# P21 VDD VDD CMOSP w=17 l=2
+  ad=0 pd=0 as=0 ps=0
M1335 a_536_512# a_505_512# 0 0 CMOSN w=40 l=2
+  ad=0 pd=0 as=0 ps=0
M1336 a_13_389# a3_in 0 0 CMOSN w=20 l=2
+  ad=100 pd=50 as=0 ps=0
M1337 C2 a_306_571# 0 0 CMOSN w=8 l=2
+  ad=40 pd=26 as=0 ps=0
M1338 a_251_218# a_233_218# VDD VDD CMOSP w=16 l=2
+  ad=80 pd=42 as=0 ps=0
M1339 0 a1 a_208_617# 0 CMOSN w=8 l=2
+  ad=0 pd=0 as=0 ps=0
M1340 0 a_296_456# a_306_423# 0 CMOSN w=8 l=2
+  ad=0 pd=0 as=0 ps=0
M1341 a_370_66# a_360_99# a_370_14# VDD CMOSP w=32 l=2
+  ad=160 pd=74 as=0 ps=0
M1342 0 CLK a_612_251# 0 CMOSN w=40 l=2
+  ad=0 pd=0 as=0 ps=0
M1343 a_251_482# a_233_482# 0 0 CMOSN w=8 l=2
+  ad=40 pd=26 as=0 ps=0
M1344 VDD P2 a_361_687# VDD CMOSP w=16 l=2
+  ad=0 pd=0 as=80 ps=42
M1345 a_233_752# b0 a0 VDD CMOSP w=16 l=2
+  ad=80 pd=42 as=0 ps=0
M1346 G34 a_305_133# 0 0 CMOSN w=8 l=2
+  ad=40 pd=26 as=0 ps=0
M1347 VDD a3 a_226_279# VDD CMOSP w=16 l=2
+  ad=0 pd=0 as=0 ps=0
M1348 S1_ff a_636_564# 0 0 CMOSN w=20 l=2
+  ad=100 pd=50 as=0 ps=0
M1349 a4 a_67_234# 0 0 CMOSN w=20 l=2
+  ad=100 pd=50 as=0 ps=0
M1350 VDD a0 a_226_681# VDD CMOSP w=16 l=2
+  ad=0 pd=0 as=0 ps=0
M1351 a_305_81# G4 VDD VDD CMOSP w=32 l=2
+  ad=0 pd=0 as=0 ps=0
M1352 0 a3 a_208_350# 0 CMOSN w=8 l=2
+  ad=0 pd=0 as=0 ps=0
M1353 a_482_227# S4 0 0 CMOSN w=20 l=2
+  ad=100 pd=50 as=0 ps=0
M1354 0 CLK a_43_345# 0 CMOSN w=40 l=2
+  ad=0 pd=0 as=0 ps=0
M1355 VDD a_366_337# a_361_345# VDD CMOSP w=17 l=2
+  ad=0 pd=0 as=85 ps=44
M1356 a_512_414# a_482_458# a_505_414# 0 CMOSN w=40 l=2
+  ad=0 pd=0 as=200 ps=90
M1357 a_167_345# a_136_345# 0 0 CMOSN w=40 l=2
+  ad=0 pd=0 as=0 ps=0
M1358 S1 a_396_752# 0 0 CMOSN w=8 l=2
+  ad=40 pd=26 as=0 ps=0
M1359 a_226_411# b2 VDD VDD CMOSP w=16 l=2
+  ad=0 pd=0 as=0 ps=0
M1360 P34 a_311_230# 0 0 CMOSN w=8 l=2
+  ad=40 pd=26 as=0 ps=0
M1361 a_67_495# a_36_443# VDD VDD CMOSP w=40 l=2
+  ad=200 pd=90 as=0 ps=0
M1362 0 a_296_604# a_306_571# 0 CMOSN w=8 l=2
+  ad=0 pd=0 as=0 ps=0
M1363 P34 a_311_230# VDD VDD CMOSP w=16 l=2
+  ad=80 pd=42 as=0 ps=0
M1364 a_370_214# a_360_247# a_370_162# VDD CMOSP w=32 l=2
+  ad=160 pd=74 as=0 ps=0
M1365 b2 a_167_495# VDD VDD CMOSP w=40 l=2
+  ad=200 pd=90 as=0 ps=0
M1366 a_370_214# G3 0 0 CMOSN w=8 l=2
+  ad=0 pd=0 as=0 ps=0
M1367 a_143_704# a_113_680# a_136_704# 0 CMOSN w=40 l=2
+  ad=0 pd=0 as=200 ps=90
M1368 S3_ff a_636_362# 0 0 CMOSN w=20 l=2
+  ad=100 pd=50 as=0 ps=0
M1369 0 a_295_166# a_305_133# 0 CMOSN w=8 l=2
+  ad=0 pd=0 as=0 ps=0
M1370 a_67_756# CLK a_67_704# 0 CMOSN w=40 l=2
+  ad=200 pd=90 as=0 ps=0
M1371 0 G1 a_320_443# 0 CMOSN w=16 l=2
+  ad=0 pd=0 as=0 ps=0
M1372 a_13_554# a1_in VDD VDD CMOSP w=80 l=2
+  ad=0 pd=0 as=0 ps=0
M1373 a_113_194# b4_in VDD VDD CMOSP w=80 l=2
+  ad=0 pd=0 as=0 ps=0
M1374 a_687_492# S0_ff a_680_388# 0 CMOSN w=10 l=2
+  ad=50 pd=30 as=0 ps=0
M1375 a_226_279# a3 a_226_316# 0 CMOSN w=16 l=2
+  ad=80 pd=42 as=0 ps=0
M1376 0 CLK a_512_512# 0 CMOSN w=40 l=2
+  ad=0 pd=0 as=0 ps=0
M1377 P1 a_251_617# VDD VDD CMOSP w=16 l=2
+  ad=0 pd=0 as=0 ps=0
M1378 a_13_680# CLK a_13_716# VDD CMOSP w=80 l=2
+  ad=400 pd=170 as=0 ps=0
M1379 VDD P4 a_311_230# VDD CMOSP w=16 l=2
+  ad=0 pd=0 as=0 ps=0
M1380 a_113_389# b3_in 0 0 CMOSN w=20 l=2
+  ad=100 pd=50 as=0 ps=0
M1381 a_371_406# G21 VDD VDD CMOSP w=32 l=2
+  ad=0 pd=0 as=0 ps=0
M1382 a_306_423# a_296_456# a_306_370# VDD CMOSP w=33 l=2
+  ad=165 pd=76 as=0 ps=0
M1383 0 C1 a_320_591# 0 CMOSN w=16 l=2
+  ad=0 pd=0 as=0 ps=0
M1384 VDD a0 a_208_752# VDD CMOSP w=16 l=2
+  ad=0 pd=0 as=80 ps=42
M1385 a_226_718# b0 0 0 CMOSN w=16 l=2
+  ad=0 pd=0 as=0 ps=0
C0 S1 S2 0.46fF
C1 a_113_650# a1 0.10fF
C2 a_378_752# 0 0.01fF
C3 a_301_453# 0 0.05fF
C4 C3 VDD 0.80fF
C5 CLK a1_in 0.10fF
C6 a0 a_136_704# 0.22fF
C7 0 a_582_458# 0.05fF
C8 CLK a_136_345# 0.10fF
C9 a_13_419# VDD 0.04fF
C10 a_582_227# S4_ff 0.10fF
C11 VDD S3_ff 0.04fF
C12 Cout CLK 0.18fF
C13 a2_in CLK 0.10fF
C14 a_167_182# a4 0.02fF
C15 a_505_512# CLK 0.10fF
C16 a_167_345# a3 0.02fF
C17 G34 P34 0.02fF
C18 a4 a_113_158# 0.10fF
C19 G1 P1 0.07fF
C20 VDD b1_in 0.13fF
C21 VDD a_36_345# 0.17fF
C22 P1 C1 0.76fF
C23 P0 a_378_752# 0.09fF
C24 G21 VDD 0.18fF
C25 a_113_194# a4 0.02fF
C26 VDD a_306_423# 0.11fF
C27 0 a_251_218# 0.02fF
C28 a_167_182# 0 0.00fF
C29 S3 a_482_458# 0.00fF
C30 S3 CLK 0.18fF
C31 a_67_293# VDD 0.13fF
C32 VDD S4_ff 0.14fF
C33 a_208_350# VDD 0.02fF
C34 0 a_113_158# 0.06fF
C35 S2_ff a_536_362# 0.03fF
C36 a_36_443# a_67_495# 0.02fF
C37 a0 a_233_752# 0.09fF
C38 a_167_234# b4 0.03fF
C39 P21 a_361_345# 1.02fF
C40 a_360_247# a_370_214# 0.27fF
C41 a_605_414# S2_ff 0.22fF
C42 a_364_622# a_389_622# 0.08fF
C43 a_233_482# 0 0.01fF
C44 P1 a_353_752# 0.48fF
C45 0 a_371_378# 0.07fF
C46 a_320_591# C2 0.01fF
C47 a_370_214# C4 0.08fF
C48 a_360_247# 0 0.22fF
C49 a_167_293# a_136_345# 0.02fF
C50 a_251_350# 0 0.02fF
C51 P21 P2 0.10fF
C52 a_167_443# 0 0.00fF
C53 VDD a_296_604# 0.22fF
C54 a4_in VDD 0.10fF
C55 b3 a3 1.00fF
C56 C4 0 0.44fF
C57 a_233_350# a_251_350# 0.05fF
C58 a_536_303# S4_ff 0.03fF
C59 0 a_370_66# 0.05fF
C60 0 a_226_681# 0.05fF
C61 0 S1 0.09fF
C62 VDD a_208_752# 0.02fF
C63 0 G4 0.05fF
C64 a_296_456# P2 0.18fF
C65 a_680_388# w_674_382# 0.11fF
C66 a_365_244# 0 0.05fF
C67 0 a_226_184# 0.00fF
C68 b2 a2 0.90fF
C69 0 a2 0.22fF
C70 CLK a_505_414# 0.10fF
C71 P1 0 0.69fF
C72 a_636_303# S4_ff 0.15fF
C73 a_113_419# a2 0.10fF
C74 a_208_617# VDD 0.02fF
C75 a_482_362# S3 0.00fF
C76 a_233_617# 0 0.01fF
C77 a4 a_167_234# 0.15fF
C78 a_296_604# a_306_571# 0.27fF
C79 a_295_166# G4 0.43fF
C80 0 a_361_687# 0.02fF
C81 P1 C2 0.13fF
C82 a4 b4_in 0.08fF
C83 a_582_227# VDD 0.04fF
C84 P0 S1 0.17fF
C85 VDD a_386_687# 0.09fF
C86 b2 a_208_482# 0.08fF
C87 a_208_482# 0 0.02fF
C88 a_233_482# a_251_482# 0.05fF
C89 VDD a_320_443# 0.00fF
C90 0 a0_in 0.02fF
C91 b2_in a2 0.08fF
C92 C2 a_361_687# 0.01fF
C93 a3 a_226_279# 0.22fF
C94 0 a_167_234# 0.01fF
C95 a_360_247# G3 0.43fF
C96 CLK a_136_182# 0.10fF
C97 P0 P1 0.78fF
C98 a_680_388# w_676_240# 0.11fF
C99 0 b4_in 0.02fF
C100 a_636_512# S0_ff 0.02fF
C101 a_13_650# CLK 0.42fF
C102 a_361_345# C1 0.64fF
C103 G1 P2 0.51fF
C104 S2_ff a_612_414# 0.02fF
C105 a_13_680# VDD 0.04fF
C106 P4 P34 0.23fF
C107 G4 G3 0.04fF
C108 G2 P1 0.07fF
C109 a3 CLK 0.23fF
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
