GauriK58/5-bit-Parallel-Prefix-Adder/magic/project.spice

* SPICE3 file created from project.ext - technology: scmos

.option scale=0.09u

M1000 a_265_644# C4 a_272_609# Gnd nfet w=20 l=2
+  ad=100 pd=50 as=180 ps=58
M1001 a_391_202# a_389_191# a_379_170# Gnd nfet w=10 l=2
+  ad=50 pd=30 as=60 ps=32
M1002 a_42_93# CLK vdd vdd pfet w=20 l=2
+  ad=100 pd=50 as=12980 ps=6018
M1003 a_285_89# P0 gnd Gnd nfet w=20 l=2
+  ad=180 pd=58 as=6700 ps=3800
M1004 a_231_450# B3 a_219_418# Gnd nfet w=10 l=2
+  ad=50 pd=30 as=60 ps=32
M1005 a_149_448# a_119_472# a_142_448# Gnd nfet w=20 l=2
+  ad=80 pd=48 as=100 ps=50
M1006 a_379_170# C2 gnd Gnd nfet w=10 l=2
+  ad=0 pd=0 as=0 ps=0
M1007 a_71_416# a_42_448# vdd vdd pfet w=20 l=2
+  ad=100 pd=50 as=0 ps=0
M1008 a_19_416# B3in vdd vdd pfet w=40 l=2
+  ad=160 pd=88 as=0 ps=0
M1009 A3 a_171_416# vdd vdd pfet w=20 l=2
+  ad=200 pd=100 as=0 ps=0
M1010 G2 a_212_288# gnd Gnd nfet w=10 l=2
+  ad=50 pd=30 as=0 ps=0
M1011 a_171_160# CLK a_171_192# Gnd nfet w=10 l=2
+  ad=50 pd=30 as=40 ps=28
M1012 a_219_66# B0 gnd Gnd nfet w=20 l=2
+  ad=160 pd=56 as=0 ps=0
M1013 a_231_101# B0 A0 vdd pfet w=20 l=2
+  ad=100 pd=50 as=200 ps=100
M1014 a_308_11# a_288_44# gnd Gnd nfet w=10 l=2
+  ad=50 pd=30 as=0 ps=0
M1015 A3 a_171_416# gnd Gnd nfet w=10 l=2
+  ad=50 pd=30 as=0 ps=0
M1016 a_219_418# A3 gnd Gnd nfet w=10 l=2
+  ad=0 pd=0 as=0 ps=0
M1017 a_171_381# CLK a_171_359# Gnd nfet w=10 l=2
+  ad=50 pd=30 as=40 ps=28
M1018 gnd CLK a_49_192# Gnd nfet w=20 l=2
+  ad=0 pd=0 as=80 ps=48
M1019 B0 a_71_125# vdd vdd pfet w=20 l=2
+  ad=100 pd=50 as=0 ps=0
M1020 a_251_162# a_231_194# gnd Gnd nfet w=10 l=2
+  ad=50 pd=30 as=0 ps=0
M1021 G2 a_212_288# vdd w_206_245# pfet w=20 l=2
+  ad=100 pd=50 as=0 ps=0
M1022 vdd a_264_283# a_267_278# w_294_255# pfet w=20 l=2
+  ad=0 pd=0 as=200 ps=100
M1023 a_212_253# A1 a_219_219# Gnd nfet w=20 l=2
+  ad=100 pd=50 as=160 ps=56
M1024 a_212_637# A4 a_219_603# Gnd nfet w=20 l=2
+  ad=100 pd=50 as=160 ps=56
M1025 a_19_361# B2in vdd vdd pfet w=40 l=2
+  ad=160 pd=88 as=0 ps=0
M1026 a_142_93# CLK vdd vdd pfet w=20 l=2
+  ad=100 pd=50 as=0 ps=0
M1027 a_315_160# a_281_160# vdd vdd pfet w=20 l=2
+  ad=100 pd=50 as=0 ps=0
M1028 a_19_335# B2in gnd Gnd nfet w=10 l=2
+  ad=50 pd=30 as=0 ps=0
M1029 a_310_357# a_276_381# vdd vdd pfet w=20 l=2
+  ad=100 pd=50 as=0 ps=0
M1030 a_313_416# a_279_416# gnd Gnd nfet w=10 l=2
+  ad=50 pd=30 as=0 ps=0
M1031 a_119_79# A0in gnd Gnd nfet w=10 l=2
+  ad=50 pd=30 as=0 ps=0
M1032 a_231_194# B1 A1 vdd pfet w=20 l=2
+  ad=100 pd=50 as=200 ps=100
M1033 a_299_619# a_265_644# vdd w_206_629# pfet w=20 l=2
+  ad=100 pd=50 as=0 ps=0
M1034 G3 a_212_509# vdd vdd pfet w=20 l=2
+  ad=100 pd=50 as=0 ps=0
M1035 C3 a_334_341# vdd vdd pfet w=20 l=2
+  ad=200 pd=100 as=0 ps=0
M1036 a_376_109# C1 vdd vdd pfet w=20 l=2
+  ad=100 pd=50 as=0 ps=0
M1037 a_171_416# a_142_448# vdd vdd pfet w=20 l=2
+  ad=100 pd=50 as=0 ps=0
M1038 a_411_170# a_391_202# gnd Gnd nfet w=10 l=2
+  ad=50 pd=30 as=0 ps=0
M1039 a_287_578# P3P2 gnd Gnd nfet w=20 l=2
+  ad=160 pd=56 as=0 ps=0
M1040 a_119_416# A3in vdd vdd pfet w=40 l=2
+  ad=160 pd=88 as=0 ps=0
M1041 a_386_348# a_384_343# a_374_370# Gnd nfet w=10 l=2
+  ad=50 pd=30 as=60 ps=32
M1042 a_336_85# G0 a_336_107# vdd pfet w=40 l=2
+  ad=200 pd=90 as=240 ps=92
M1043 a_71_125# a_42_93# vdd vdd pfet w=20 l=2
+  ad=100 pd=50 as=0 ps=0
M1044 gnd CLK a_149_192# Gnd nfet w=20 l=2
+  ad=0 pd=0 as=80 ps=48
M1045 A0 a_171_125# vdd vdd pfet w=20 l=2
+  ad=0 pd=0 as=0 ps=0
M1046 a_219_379# A2 vdd vdd pfet w=20 l=2
+  ad=100 pd=50 as=0 ps=0
M1047 a_276_381# C2 a_283_347# Gnd nfet w=20 l=2
+  ad=100 pd=50 as=160 ps=56
M1048 a_374_370# C3 vdd vdd pfet w=20 l=2
+  ad=100 pd=50 as=0 ps=0
M1049 a_281_160# C1 vdd vdd pfet w=20 l=2
+  ad=200 pd=100 as=0 ps=0
M1050 gnd G4 a_323_619# Gnd nfet w=10 l=2
+  ad=0 pd=0 as=60 ps=32
M1051 a_119_361# A2in vdd vdd pfet w=40 l=2
+  ad=160 pd=88 as=0 ps=0
M1052 a_219_322# B2 gnd Gnd nfet w=20 l=2
+  ad=160 pd=56 as=0 ps=0
M1053 P2 a_251_357# vdd vdd pfet w=20 l=2
+  ad=100 pd=50 as=0 ps=0
M1054 a_19_216# CLK a_19_160# vdd pfet w=40 l=2
+  ad=200 pd=90 as=160 ps=88
M1055 a_410_556# a_390_588# vdd vdd pfet w=20 l=2
+  ad=100 pd=50 as=0 ps=0
M1056 a_337_414# a_313_416# vdd vdd pfet w=40 l=2
+  ad=240 pd=92 as=0 ps=0
M1057 a_119_335# A2in gnd Gnd nfet w=10 l=2
+  ad=50 pd=30 as=0 ps=0
M1058 P0 a_251_101# gnd Gnd nfet w=10 l=2
+  ad=50 pd=30 as=0 ps=0
M1059 a_313_416# a_279_416# vdd vdd pfet w=20 l=2
+  ad=100 pd=50 as=0 ps=0
M1060 vdd B2 a_212_288# w_206_245# pfet w=20 l=2
+  ad=0 pd=0 as=200 ps=100
M1061 a_71_544# CLK a_71_576# Gnd nfet w=10 l=2
+  ad=50 pd=30 as=40 ps=28
M1062 a_279_416# G2 a_286_450# Gnd nfet w=20 l=2
+  ad=100 pd=50 as=160 ps=56
M1063 a_251_101# a_231_101# vdd vdd pfet w=20 l=2
+  ad=100 pd=50 as=0 ps=0
M1064 a_323_619# a_299_619# gnd Gnd nfet w=10 l=2
+  ad=0 pd=0 as=0 ps=0
M1065 a_71_192# a_42_192# gnd Gnd nfet w=10 l=2
+  ad=40 pd=28 as=0 ps=0
M1066 G3 a_212_509# gnd Gnd nfet w=10 l=2
+  ad=50 pd=30 as=0 ps=0
M1067 a_49_93# a_19_79# a_42_93# Gnd nfet w=20 l=2
+  ad=80 pd=48 as=100 ps=50
M1068 a_71_359# a_42_349# gnd Gnd nfet w=10 l=2
+  ad=40 pd=28 as=0 ps=0
M1069 a_171_125# a_142_93# vdd vdd pfet w=20 l=2
+  ad=100 pd=50 as=0 ps=0
M1070 vdd B3 a_212_509# vdd pfet w=20 l=2
+  ad=0 pd=0 as=200 ps=100
M1071 a_315_160# a_281_160# gnd Gnd nfet w=10 l=2
+  ad=50 pd=30 as=0 ps=0
M1072 gnd CLK a_49_93# Gnd nfet w=20 l=2
+  ad=0 pd=0 as=0 ps=0
M1073 a_390_588# a_388_577# C4 vdd pfet w=20 l=2
+  ad=100 pd=50 as=200 ps=100
M1074 a_279_416# G2 vdd vdd pfet w=20 l=2
+  ad=200 pd=100 as=0 ps=0
M1075 a_119_216# CLK a_119_160# vdd pfet w=40 l=2
+  ad=200 pd=90 as=160 ps=88
M1076 a_42_192# CLK vdd vdd pfet w=20 l=2
+  ad=100 pd=50 as=0 ps=0
M1077 a_251_162# a_231_194# vdd vdd pfet w=20 l=2
+  ad=100 pd=50 as=0 ps=0
M1078 a_219_418# A3 vdd vdd pfet w=20 l=2
+  ad=100 pd=50 as=0 ps=0
M1079 a_42_349# CLK vdd vdd pfet w=20 l=2
+  ad=100 pd=50 as=0 ps=0
M1080 a_339_210# a_315_160# gnd Gnd nfet w=10 l=2
+  ad=60 pd=32 as=0 ps=0
M1081 a_171_544# CLK a_171_576# Gnd nfet w=10 l=2
+  ad=50 pd=30 as=40 ps=28
M1082 a_406_348# a_386_348# gnd Gnd nfet w=10 l=2
+  ad=50 pd=30 as=0 ps=0
M1083 a_411_170# a_391_202# vdd vdd pfet w=20 l=2
+  ad=100 pd=50 as=0 ps=0
M1084 P3 a_251_418# vdd vdd pfet w=20 l=2
+  ad=100 pd=50 as=0 ps=0
M1085 a_251_357# a_231_357# gnd Gnd nfet w=10 l=2
+  ad=50 pd=30 as=0 ps=0
M1086 a_334_341# a_310_357# gnd Gnd nfet w=10 l=2
+  ad=60 pd=32 as=0 ps=0
M1087 a_288_44# C0 a_276_11# Gnd nfet w=10 l=2
+  ad=50 pd=30 as=60 ps=32
M1088 gnd CLK a_49_576# Gnd nfet w=20 l=2
+  ad=0 pd=0 as=80 ps=48
M1089 a_251_546# a_231_578# gnd Gnd nfet w=10 l=2
+  ad=50 pd=30 as=0 ps=0
M1090 C1 a_336_85# vdd vdd pfet w=20 l=2
+  ad=200 pd=100 as=0 ps=0
M1091 a_171_192# a_142_192# gnd Gnd nfet w=10 l=2
+  ad=0 pd=0 as=0 ps=0
M1092 a_339_158# a_315_160# vdd vdd pfet w=40 l=2
+  ad=240 pd=92 as=0 ps=0
M1093 a_386_348# a_384_343# C3 vdd pfet w=20 l=2
+  ad=100 pd=50 as=0 ps=0
M1094 a_171_359# a_142_349# gnd Gnd nfet w=10 l=2
+  ad=0 pd=0 as=0 ps=0
M1095 a_49_192# a_19_216# a_42_192# Gnd nfet w=20 l=2
+  ad=0 pd=0 as=100 ps=50
M1096 C2 a_339_210# vdd vdd pfet w=20 l=2
+  ad=200 pd=100 as=0 ps=0
M1097 a_281_160# C1 a_288_194# Gnd nfet w=20 l=2
+  ad=100 pd=50 as=160 ps=56
M1098 a_337_466# a_313_416# gnd Gnd nfet w=10 l=2
+  ad=60 pd=32 as=0 ps=0
M1099 a_212_253# A1 vdd w_206_245# pfet w=20 l=2
+  ad=200 pd=100 as=0 ps=0
M1100 B1 a_71_160# vdd vdd pfet w=20 l=2
+  ad=100 pd=50 as=0 ps=0
M1101 S0 a_308_11# vdd w_263_0# pfet w=20 l=2
+  ad=100 pd=50 as=0 ps=0
M1102 a_231_101# B0 a_219_123# Gnd nfet w=10 l=2
+  ad=50 pd=30 as=60 ps=32
M1103 a_231_578# B4 A4 vdd pfet w=20 l=2
+  ad=100 pd=50 as=200 ps=100
M1104 B2 a_71_381# vdd vdd pfet w=20 l=2
+  ad=100 pd=50 as=0 ps=0
M1105 a_219_603# B4 gnd Gnd nfet w=20 l=2
+  ad=0 pd=0 as=0 ps=0
M1106 a_212_509# A3 a_219_475# Gnd nfet w=20 l=2
+  ad=100 pd=50 as=160 ps=56
M1107 B1 a_71_160# gnd Gnd nfet w=10 l=2
+  ad=50 pd=30 as=0 ps=0
M1108 a_219_219# B1 gnd Gnd nfet w=20 l=2
+  ad=0 pd=0 as=0 ps=0
M1109 S1 a_408_87# gnd Gnd nfet w=10 l=2
+  ad=50 pd=30 as=0 ps=0
M1110 a_278_125# C0 vdd vdd pfet w=20 l=2
+  ad=200 pd=100 as=0 ps=0
M1111 a_142_192# CLK vdd vdd pfet w=20 l=2
+  ad=100 pd=50 as=0 ps=0
M1112 a_323_619# G4 a_323_641# w_206_629# pfet w=40 l=2
+  ad=200 pd=90 as=240 ps=92
M1113 C4 a_338_594# gnd Gnd nfet w=10 l=2
+  ad=50 pd=30 as=0 ps=0
M1114 gnd CLK a_49_349# Gnd nfet w=20 l=2
+  ad=0 pd=0 as=80 ps=48
M1115 a_142_349# CLK vdd vdd pfet w=20 l=2
+  ad=100 pd=50 as=0 ps=0
M1116 a_391_202# a_389_191# C2 vdd pfet w=20 l=2
+  ad=100 pd=50 as=0 ps=0
M1117 S4 a_410_556# gnd Gnd nfet w=10 l=2
+  ad=50 pd=30 as=0 ps=0
M1118 B2 a_71_381# gnd Gnd nfet w=10 l=2
+  ad=50 pd=30 as=0 ps=0
M1119 a_336_85# a_312_101# gnd Gnd nfet w=10 l=2
+  ad=60 pd=32 as=0 ps=0
M1120 a_337_466# G3 a_337_414# vdd pfet w=40 l=2
+  ad=200 pd=90 as=0 ps=0
M1121 gnd CLK a_149_576# Gnd nfet w=20 l=2
+  ad=0 pd=0 as=80 ps=48
M1122 a_219_123# A0 gnd Gnd nfet w=10 l=2
+  ad=0 pd=0 as=0 ps=0
M1123 a_251_418# a_231_450# gnd Gnd nfet w=10 l=2
+  ad=50 pd=30 as=0 ps=0
M1124 a_71_125# CLK a_71_103# Gnd nfet w=10 l=2
+  ad=50 pd=30 as=40 ps=28
M1125 a_323_641# a_299_619# vdd w_206_629# pfet w=40 l=2
+  ad=0 pd=0 as=0 ps=0
M1126 a_19_600# CLK a_19_544# vdd pfet w=40 l=2
+  ad=200 pd=90 as=160 ps=88
M1127 a_149_192# a_119_216# a_142_192# Gnd nfet w=20 l=2
+  ad=0 pd=0 as=100 ps=50
M1128 a_19_216# B1in gnd Gnd nfet w=10 l=2
+  ad=50 pd=30 as=0 ps=0
M1129 a_19_600# B4in gnd Gnd nfet w=10 l=2
+  ad=50 pd=30 as=0 ps=0
M1130 a_71_160# a_42_192# vdd vdd pfet w=20 l=2
+  ad=100 pd=50 as=0 ps=0
M1131 a_71_381# a_42_349# vdd vdd pfet w=20 l=2
+  ad=100 pd=50 as=0 ps=0
M1132 a_276_381# C2 vdd vdd pfet w=20 l=2
+  ad=200 pd=100 as=0 ps=0
M1133 a_267_278# a_264_294# vdd w_294_255# pfet w=20 l=2
+  ad=0 pd=0 as=0 ps=0
M1134 a_19_160# B1in vdd vdd pfet w=40 l=2
+  ad=0 pd=0 as=0 ps=0
M1135 A1 a_171_160# vdd vdd pfet w=20 l=2
+  ad=0 pd=0 as=0 ps=0
M1136 A2 a_171_381# vdd vdd pfet w=20 l=2
+  ad=200 pd=100 as=0 ps=0
M1137 a_283_347# P2 gnd Gnd nfet w=20 l=2
+  ad=0 pd=0 as=0 ps=0
M1138 a_408_87# a_388_87# vdd vdd pfet w=20 l=2
+  ad=100 pd=50 as=0 ps=0
M1139 a_376_109# C1 gnd Gnd nfet w=10 l=2
+  ad=60 pd=32 as=0 ps=0
M1140 vdd P1 a_281_160# vdd pfet w=20 l=2
+  ad=0 pd=0 as=0 ps=0
M1141 A1 a_171_160# gnd Gnd nfet w=10 l=2
+  ad=50 pd=30 as=0 ps=0
M1142 a_71_576# a_42_576# gnd Gnd nfet w=10 l=2
+  ad=0 pd=0 as=0 ps=0
M1143 gnd CLK a_149_349# Gnd nfet w=20 l=2
+  ad=0 pd=0 as=80 ps=48
M1144 A2 a_171_381# gnd Gnd nfet w=10 l=2
+  ad=50 pd=30 as=0 ps=0
M1145 P1 a_251_162# gnd Gnd nfet w=10 l=2
+  ad=50 pd=30 as=0 ps=0
M1146 a_19_79# CLK a_19_105# vdd pfet w=40 l=2
+  ad=200 pd=90 as=160 ps=88
M1147 a_286_450# P3 gnd Gnd nfet w=20 l=2
+  ad=0 pd=0 as=0 ps=0
M1148 gnd G1 a_339_210# Gnd nfet w=10 l=2
+  ad=0 pd=0 as=0 ps=0
M1149 a_406_348# a_386_348# vdd vdd pfet w=20 l=2
+  ad=100 pd=50 as=0 ps=0
M1150 a_288_44# C0 P0 w_263_0# pfet w=20 l=2
+  ad=100 pd=50 as=200 ps=100
M1151 vdd a_265_630# a_265_644# w_206_629# pfet w=20 l=2
+  ad=0 pd=0 as=200 ps=100
M1152 a_119_600# CLK a_119_544# vdd pfet w=40 l=2
+  ad=200 pd=90 as=160 ps=88
M1153 a_310_357# a_276_381# gnd Gnd nfet w=10 l=2
+  ad=50 pd=30 as=0 ps=0
M1154 gnd G2 a_334_341# Gnd nfet w=10 l=2
+  ad=0 pd=0 as=0 ps=0
M1155 a_171_125# CLK a_171_103# Gnd nfet w=10 l=2
+  ad=50 pd=30 as=40 ps=28
M1156 G1 a_212_253# vdd w_206_245# pfet w=20 l=2
+  ad=100 pd=50 as=0 ps=0
M1157 a_272_609# a_265_630# gnd Gnd nfet w=20 l=2
+  ad=0 pd=0 as=0 ps=0
M1158 a_42_576# CLK vdd vdd pfet w=20 l=2
+  ad=100 pd=50 as=0 ps=0
M1159 a_251_546# a_231_578# vdd vdd pfet w=20 l=2
+  ad=100 pd=50 as=0 ps=0
M1160 a_119_216# A1in gnd Gnd nfet w=10 l=2
+  ad=50 pd=30 as=0 ps=0
M1161 a_339_210# G1 a_339_158# vdd pfet w=40 l=2
+  ad=200 pd=90 as=0 ps=0
M1162 a_119_600# A4in gnd Gnd nfet w=10 l=2
+  ad=50 pd=30 as=0 ps=0
M1163 a_171_160# a_142_192# vdd vdd pfet w=20 l=2
+  ad=100 pd=50 as=0 ps=0
M1164 a_71_416# CLK a_71_448# Gnd nfet w=10 l=2
+  ad=50 pd=30 as=40 ps=28
M1165 a_171_381# a_142_349# vdd vdd pfet w=20 l=2
+  ad=100 pd=50 as=0 ps=0
M1166 a_119_160# A1in vdd vdd pfet w=40 l=2
+  ad=0 pd=0 as=0 ps=0
M1167 a_388_87# P1 C1 vdd pfet w=20 l=2
+  ad=100 pd=50 as=0 ps=0
M1168 a_267_285# a_264_283# a_267_278# Gnd nfet w=20 l=2
+  ad=180 pd=58 as=100 ps=50
M1169 a_312_101# a_278_125# vdd vdd pfet w=20 l=2
+  ad=100 pd=50 as=0 ps=0
M1170 S2 a_411_170# gnd Gnd nfet w=10 l=2
+  ad=50 pd=30 as=0 ps=0
M1171 gnd G3 a_337_466# Gnd nfet w=10 l=2
+  ad=0 pd=0 as=0 ps=0
M1172 a_171_576# a_142_576# gnd Gnd nfet w=10 l=2
+  ad=0 pd=0 as=0 ps=0
M1173 vdd P3 a_279_416# vdd pfet w=20 l=2
+  ad=0 pd=0 as=0 ps=0
M1174 a_149_93# a_119_79# a_142_93# Gnd nfet w=20 l=2
+  ad=80 pd=48 as=100 ps=50
M1175 a_338_542# a_314_544# vdd vdd pfet w=40 l=2
+  ad=240 pd=92 as=0 ps=0
M1176 a_308_11# a_288_44# vdd w_263_0# pfet w=20 l=2
+  ad=100 pd=50 as=0 ps=0
M1177 G0 a_212_32# vdd w_206_26# pfet w=20 l=2
+  ad=100 pd=50 as=0 ps=0
M1178 a_49_576# a_19_600# a_42_576# Gnd nfet w=20 l=2
+  ad=0 pd=0 as=100 ps=50
M1179 a_314_544# a_280_544# vdd vdd pfet w=20 l=2
+  ad=100 pd=50 as=0 ps=0
M1180 a_231_357# B2 A2 vdd pfet w=20 l=2
+  ad=100 pd=50 as=0 ps=0
M1181 a_119_79# CLK a_119_105# vdd pfet w=40 l=2
+  ad=200 pd=90 as=160 ps=88
M1182 C1 a_336_85# gnd Gnd nfet w=10 l=2
+  ad=50 pd=30 as=0 ps=0
M1183 a_212_637# A4 vdd w_206_629# pfet w=20 l=2
+  ad=200 pd=100 as=0 ps=0
M1184 C5 a_323_619# gnd Gnd nfet w=10 l=2
+  ad=50 pd=30 as=0 ps=0
M1185 C4 a_338_594# vdd vdd pfet w=20 l=2
+  ad=0 pd=0 as=0 ps=0
M1186 a_408_87# a_388_87# gnd Gnd nfet w=10 l=2
+  ad=50 pd=30 as=0 ps=0
M1187 gnd CLK a_149_93# Gnd nfet w=20 l=2
+  ad=0 pd=0 as=0 ps=0
M1188 B4 a_71_544# vdd vdd pfet w=20 l=2
+  ad=100 pd=50 as=0 ps=0
M1189 S4 a_410_556# vdd vdd pfet w=20 l=2
+  ad=100 pd=50 as=0 ps=0
M1190 a_219_123# A0 vdd vdd pfet w=20 l=2
+  ad=100 pd=50 as=0 ps=0
M1191 B4 a_71_544# gnd Gnd nfet w=10 l=2
+  ad=50 pd=30 as=0 ps=0
M1192 a_142_576# CLK vdd vdd pfet w=20 l=2
+  ad=100 pd=50 as=0 ps=0
M1193 a_212_32# A0 vdd w_206_26# pfet w=20 l=2
+  ad=200 pd=100 as=0 ps=0
M1194 P0 a_251_101# vdd vdd pfet w=20 l=2
+  ad=0 pd=0 as=0 ps=0
M1195 a_288_194# P1 gnd Gnd nfet w=20 l=2
+  ad=0 pd=0 as=0 ps=0
M1196 a_171_416# CLK a_171_448# Gnd nfet w=10 l=2
+  ad=50 pd=30 as=40 ps=28
M1197 gnd CLK a_49_448# Gnd nfet w=20 l=2
+  ad=0 pd=0 as=80 ps=48
M1198 vdd B1 a_212_253# w_206_245# pfet w=20 l=2
+  ad=0 pd=0 as=0 ps=0
M1199 a_49_349# a_19_335# a_42_349# Gnd nfet w=20 l=2
+  ad=0 pd=0 as=100 ps=50
M1200 a_231_194# B1 a_219_162# Gnd nfet w=10 l=2
+  ad=50 pd=30 as=60 ps=32
M1201 a_280_544# C2 vdd vdd pfet w=20 l=2
+  ad=200 pd=100 as=0 ps=0
M1202 a_149_576# a_119_600# a_142_576# Gnd nfet w=20 l=2
+  ad=0 pd=0 as=100 ps=50
M1203 a_219_475# B3 gnd Gnd nfet w=20 l=2
+  ad=0 pd=0 as=0 ps=0
M1204 C3 a_334_341# gnd Gnd nfet w=10 l=2
+  ad=50 pd=30 as=0 ps=0
M1205 a_219_162# A1 vdd vdd pfet w=20 l=2
+  ad=100 pd=50 as=0 ps=0
M1206 a_71_544# a_42_576# vdd vdd pfet w=20 l=2
+  ad=100 pd=50 as=0 ps=0
M1207 a_71_103# a_42_93# gnd Gnd nfet w=10 l=2
+  ad=0 pd=0 as=0 ps=0
M1208 a_19_544# B4in vdd vdd pfet w=40 l=2
+  ad=0 pd=0 as=0 ps=0
M1209 A4 a_171_544# vdd vdd pfet w=20 l=2
+  ad=0 pd=0 as=0 ps=0
M1210 P1 a_251_162# vdd vdd pfet w=20 l=2
+  ad=100 pd=50 as=0 ps=0
M1211 a_231_450# B3 A3 vdd pfet w=20 l=2
+  ad=100 pd=50 as=0 ps=0
M1212 a_219_162# A1 gnd Gnd nfet w=10 l=2
+  ad=0 pd=0 as=0 ps=0
M1213 A4 a_171_544# gnd Gnd nfet w=10 l=2
+  ad=50 pd=30 as=0 ps=0
M1214 S3 a_406_348# gnd Gnd nfet w=10 l=2
+  ad=50 pd=30 as=0 ps=0
M1215 a_312_101# a_278_125# gnd Gnd nfet w=10 l=2
+  ad=50 pd=30 as=0 ps=0
M1216 S2 a_411_170# vdd vdd pfet w=20 l=2
+  ad=100 pd=50 as=0 ps=0
M1217 P3G2+G3 a_337_466# gnd Gnd nfet w=10 l=2
+  ad=50 pd=30 as=0 ps=0
M1218 P4 a_251_546# gnd Gnd nfet w=10 l=2
+  ad=50 pd=30 as=0 ps=0
M1219 P2 a_251_357# gnd Gnd nfet w=10 l=2
+  ad=50 pd=30 as=0 ps=0
M1220 a_276_11# P0 vdd w_263_0# pfet w=20 l=2
+  ad=100 pd=50 as=0 ps=0
M1221 a_338_594# a_314_544# gnd Gnd nfet w=10 l=2
+  ad=60 pd=32 as=0 ps=0
M1222 G0 a_212_32# gnd Gnd nfet w=10 l=2
+  ad=50 pd=30 as=0 ps=0
M1223 a_19_472# B3in gnd Gnd nfet w=10 l=2
+  ad=50 pd=30 as=0 ps=0
M1224 gnd CLK a_149_448# Gnd nfet w=20 l=2
+  ad=0 pd=0 as=0 ps=0
M1225 vdd P2 a_276_381# vdd pfet w=20 l=2
+  ad=0 pd=0 as=0 ps=0
M1226 a_334_363# a_310_357# vdd vdd pfet w=40 l=2
+  ad=240 pd=92 as=0 ps=0
M1227 a_314_544# a_280_544# gnd Gnd nfet w=10 l=2
+  ad=50 pd=30 as=0 ps=0
M1228 a_251_357# a_231_357# vdd vdd pfet w=20 l=2
+  ad=100 pd=50 as=0 ps=0
M1229 a_149_349# a_119_335# a_142_349# Gnd nfet w=20 l=2
+  ad=0 pd=0 as=100 ps=50
M1230 a_251_101# a_231_101# gnd Gnd nfet w=10 l=2
+  ad=50 pd=30 as=0 ps=0
M1231 vdd a_267_278# P3P2 w_294_255# pfet w=20 l=2
+  ad=0 pd=0 as=100 ps=50
M1232 G4 a_212_637# vdd w_206_629# pfet w=20 l=2
+  ad=100 pd=50 as=0 ps=0
M1233 a_19_472# CLK a_19_416# vdd pfet w=40 l=2
+  ad=200 pd=90 as=0 ps=0
M1234 a_19_105# B0in vdd vdd pfet w=40 l=2
+  ad=0 pd=0 as=0 ps=0
M1235 gnd G0 a_336_85# Gnd nfet w=10 l=2
+  ad=0 pd=0 as=0 ps=0
M1236 a_19_79# B0in gnd Gnd nfet w=10 l=2
+  ad=50 pd=30 as=0 ps=0
M1237 a_171_544# a_142_576# vdd vdd pfet w=20 l=2
+  ad=100 pd=50 as=0 ps=0
M1238 a_338_594# P3G2+G3 a_338_542# vdd pfet w=40 l=2
+  ad=200 pd=90 as=0 ps=0
M1239 a_212_32# A0 a_219_66# Gnd nfet w=20 l=2
+  ad=100 pd=50 as=0 ps=0
M1240 a_171_103# a_142_93# gnd Gnd nfet w=10 l=2
+  ad=0 pd=0 as=0 ps=0
M1241 a_119_544# A4in vdd vdd pfet w=40 l=2
+  ad=0 pd=0 as=0 ps=0
M1242 a_19_335# CLK a_19_361# vdd pfet w=40 l=2
+  ad=200 pd=90 as=0 ps=0
M1243 C5 a_323_619# vdd w_206_629# pfet w=20 l=2
+  ad=100 pd=50 as=0 ps=0
M1244 a_390_588# a_388_577# a_378_556# Gnd nfet w=10 l=2
+  ad=50 pd=30 as=60 ps=32
M1245 a_71_448# a_42_448# gnd Gnd nfet w=10 l=2
+  ad=0 pd=0 as=0 ps=0
M1246 S0 a_308_11# gnd Gnd nfet w=10 l=2
+  ad=50 pd=30 as=0 ps=0
M1247 a_299_619# a_265_644# gnd Gnd nfet w=10 l=2
+  ad=50 pd=30 as=0 ps=0
M1248 a_280_544# C2 a_287_578# Gnd nfet w=20 l=2
+  ad=100 pd=50 as=0 ps=0
M1249 a_119_472# A3in gnd Gnd nfet w=10 l=2
+  ad=50 pd=30 as=0 ps=0
M1250 a_378_556# C4 vdd vdd pfet w=20 l=2
+  ad=100 pd=50 as=0 ps=0
M1251 P3 a_251_418# gnd Gnd nfet w=10 l=2
+  ad=50 pd=30 as=0 ps=0
M1252 B0 a_71_125# gnd Gnd nfet w=10 l=2
+  ad=50 pd=30 as=0 ps=0
M1253 a_388_87# P1 a_376_109# Gnd nfet w=10 l=2
+  ad=50 pd=30 as=0 ps=0
M1254 a_378_556# C4 gnd Gnd nfet w=10 l=2
+  ad=0 pd=0 as=0 ps=0
M1255 a_119_472# CLK a_119_416# vdd pfet w=40 l=2
+  ad=200 pd=90 as=0 ps=0
M1256 a_119_105# A0in vdd vdd pfet w=40 l=2
+  ad=0 pd=0 as=0 ps=0
M1257 a_42_448# CLK vdd vdd pfet w=20 l=2
+  ad=100 pd=50 as=0 ps=0
M1258 a_251_418# a_231_450# vdd vdd pfet w=20 l=2
+  ad=100 pd=50 as=0 ps=0
M1259 a_212_288# A2 a_219_322# Gnd nfet w=20 l=2
+  ad=100 pd=50 as=0 ps=0
M1260 vdd B0 a_212_32# w_206_26# pfet w=20 l=2
+  ad=0 pd=0 as=0 ps=0
M1261 a_119_335# CLK a_119_361# vdd pfet w=40 l=2
+  ad=200 pd=90 as=0 ps=0
M1262 S1 a_408_87# vdd vdd pfet w=20 l=2
+  ad=100 pd=50 as=0 ps=0
M1263 a_212_288# A2 vdd w_206_245# pfet w=20 l=2
+  ad=0 pd=0 as=0 ps=0
M1264 vdd B4 a_212_637# w_206_629# pfet w=20 l=2
+  ad=0 pd=0 as=0 ps=0
M1265 a_231_578# B4 a_219_546# Gnd nfet w=10 l=2
+  ad=50 pd=30 as=60 ps=32
M1266 a_231_357# B2 a_219_379# Gnd nfet w=10 l=2
+  ad=50 pd=30 as=60 ps=32
M1267 a_171_448# a_142_448# gnd Gnd nfet w=10 l=2
+  ad=0 pd=0 as=0 ps=0
M1268 a_276_11# P0 gnd Gnd nfet w=10 l=2
+  ad=0 pd=0 as=0 ps=0
M1269 a_49_448# a_19_472# a_42_448# Gnd nfet w=20 l=2
+  ad=0 pd=0 as=100 ps=50
M1270 S3 a_406_348# vdd vdd pfet w=20 l=2
+  ad=100 pd=50 as=0 ps=0
M1271 G1 a_212_253# gnd Gnd nfet w=10 l=2
+  ad=50 pd=30 as=0 ps=0
M1272 a_278_125# C0 a_285_89# Gnd nfet w=20 l=2
+  ad=100 pd=50 as=0 ps=0
M1273 C2 a_339_210# gnd Gnd nfet w=10 l=2
+  ad=50 pd=30 as=0 ps=0
M1274 G4 a_212_637# gnd Gnd nfet w=10 l=2
+  ad=50 pd=30 as=0 ps=0
M1275 a_219_546# A4 vdd vdd pfet w=20 l=2
+  ad=100 pd=50 as=0 ps=0
M1276 a_374_370# C3 gnd Gnd nfet w=10 l=2
+  ad=0 pd=0 as=0 ps=0
M1277 gnd a_264_294# a_267_285# Gnd nfet w=20 l=2
+  ad=0 pd=0 as=0 ps=0
M1278 a_336_107# a_312_101# vdd vdd pfet w=40 l=2
+  ad=0 pd=0 as=0 ps=0
M1279 A0 a_171_125# gnd Gnd nfet w=10 l=2
+  ad=50 pd=30 as=0 ps=0
M1280 vdd P0 a_278_125# vdd pfet w=20 l=2
+  ad=0 pd=0 as=0 ps=0
M1281 P3G2+G3 a_337_466# vdd vdd pfet w=20 l=2
+  ad=100 pd=50 as=0 ps=0
M1282 a_219_546# A4 gnd Gnd nfet w=10 l=2
+  ad=0 pd=0 as=0 ps=0
M1283 P4 a_251_546# vdd vdd pfet w=20 l=2
+  ad=100 pd=50 as=0 ps=0
M1284 a_212_509# A3 vdd vdd pfet w=20 l=2
+  ad=0 pd=0 as=0 ps=0
M1285 B3 a_71_416# vdd vdd pfet w=20 l=2
+  ad=100 pd=50 as=0 ps=0
M1286 a_219_379# A2 gnd Gnd nfet w=10 l=2
+  ad=0 pd=0 as=0 ps=0
M1287 gnd a_267_278# P3P2 Gnd nfet w=10 l=2
+  ad=0 pd=0 as=50 ps=30
M1288 a_71_160# CLK a_71_192# Gnd nfet w=10 l=2
+  ad=50 pd=30 as=0 ps=0
M1289 a_265_644# C4 vdd w_206_629# pfet w=20 l=2
+  ad=0 pd=0 as=0 ps=0
M1290 gnd P3G2+G3 a_338_594# Gnd nfet w=10 l=2
+  ad=0 pd=0 as=0 ps=0
M1291 a_334_341# G2 a_334_363# vdd pfet w=40 l=2
+  ad=200 pd=90 as=0 ps=0
M1292 a_379_170# C2 vdd vdd pfet w=20 l=2
+  ad=100 pd=50 as=0 ps=0
M1293 vdd P3P2 a_280_544# vdd pfet w=20 l=2
+  ad=0 pd=0 as=0 ps=0
M1294 a_410_556# a_390_588# gnd Gnd nfet w=10 l=2
+  ad=50 pd=30 as=0 ps=0
M1295 B3 a_71_416# gnd Gnd nfet w=10 l=2
+  ad=50 pd=30 as=0 ps=0
M1296 a_142_448# CLK vdd vdd pfet w=20 l=2
+  ad=100 pd=50 as=0 ps=0
M1297 a_71_381# CLK a_71_359# Gnd nfet w=10 l=2
+  ad=50 pd=30 as=0 ps=0
C0 a_276_381# a_310_357# 0.09fF
C1 vdd a_19_216# 0.03fF
C2 w_206_629# A4 0.08fF
C3 vdd a_313_416# 0.14fF
C4 B4 a_219_546# 0.00fF
C5 vdd a_142_448# 0.14fF
C6 a_42_192# a_71_160# 0.02fF
C7 B4 a_149_576# 0.00fF
C8 a_171_448# B3 0.00fF
C9 gnd a_231_194# 0.02fF
C10 a_19_335# gnd 0.29fF
C11 a_251_162# gnd 0.02fF
C12 a_390_588# gnd 0.02fF
C13 a_336_107# a_336_85# 0.00fF
C14 P1 P0 0.00fF
C15 B2 a_149_349# 0.00fF
C16 B4 a_119_544# 0.00fF
C17 a_142_448# B3 0.01fF
C18 A0in B0 0.03fF
C19 B1 a_171_160# 0.01fF
C20 P3 a_264_294# 0.06fF
C21 gnd a_19_216# 0.29fF
C22 A1 a_212_253# 0.23fF
C23 a_251_162# a_231_194# 0.05fF
C24 B2 a_142_349# 0.01fF
C25 CLK a_42_192# 0.10fF
C26 a_231_357# a_251_357# 0.05fF
C27 C1 G0 0.04fF
C28 a_212_32# w_206_26# 0.18fF
C29 a_339_210# vdd 0.13fF
C30 vdd A3 0.54fF
C31 vdd S1 0.02fF
C32 a_219_219# A1 0.04fF
C33 vdd a_142_349# 0.14fF
C34 a_212_32# A0 0.23fF
C35 P0 a_278_125# 0.14fF
C36 B1 A1in 0.03fF
C37 a_267_278# a_264_294# 0.06fF
C38 a_314_544# P3P2 0.13fF
C39 vdd a_389_191# 0.10fF
C40 a_279_416# G2 0.29fF
C41 vdd a_336_85# 0.13fF
C42 B3 A3 0.39fF
C43 vdd C0 0.08fF
C44 a_386_348# a_374_370# 0.08fF
C45 a_42_349# CLK 0.10fF
C46 a_314_544# a_280_544# 0.11fF
C47 a_171_544# A4 0.03fF
C48 w_206_629# a_212_637# 0.18fF
C49 P2 a_389_191# 0.04fF
C50 B0 w_206_26# 0.08fF
C51 a_334_341# vdd 0.13fF
C52 a_119_361# B2 0.00fF
C53 gnd A3 0.15fF
C54 A0 B0 0.39fF
C55 B1 a_219_162# 0.00fF
C56 P4 a_299_619# 0.16fF
C57 a_119_472# vdd 0.03fF
C58 C2 P3P2 0.18fF
C59 a_386_348# P3 0.02fF
C60 P4 a_323_619# 0.04fF
C61 C2 P3 0.34fF
C62 a_142_576# CLK 0.10fF
C63 vdd a_410_556# 0.09fF
C64 P4 a_265_644# 0.16fF
C65 C0 gnd 0.20fF
C66 B2 a_119_335# 0.12fF
C67 a_119_472# B3 0.12fF
C68 vdd a_142_93# 0.14fF
C69 C2 a_280_544# 0.20fF
C70 G2 w_206_245# 0.03fF
C71 vdd G1 0.06fF
C72 vdd w_294_255# 0.14fF
C73 a_42_448# a_71_416# 0.02fF
C74 a_42_448# vdd 0.14fF
C75 A4in CLK 0.10fF
C76 vdd G3 0.09fF
C77 a_71_125# B0 0.03fF
C78 C2 a_267_278# 0.01fF
C79 vdd a_119_335# 0.03fF
C80 vdd a_19_79# 0.03fF
C81 a_171_381# A2 0.03fF
C82 G2 P3 0.19fF
C83 a_119_472# gnd 0.25fF
C84 P2 G1 0.09fF
C85 C2 a_379_170# 0.08fF
C86 a_171_103# B0 0.00fF
C87 a_276_381# P3 0.06fF
C88 a_410_556# gnd 0.02fF
C89 vdd a_19_472# 0.03fF
C90 w_206_629# a_299_619# 0.09fF
C91 a_288_44# a_308_11# 0.05fF
C92 C1 vdd 2.09fF
C93 vdd a_388_577# 0.10fF
C94 G1 gnd 0.23fF
C95 w_206_629# a_323_619# 0.13fF
C96 P2 a_267_285# 0.02fF
C97 gnd G3 0.13fF
C98 a_219_123# a_231_101# 0.08fF
C99 gnd a_119_335# 0.25fF
C100 P4 vdd 0.04fF
C101 a_19_79# gnd 0.29fF
C102 w_206_629# a_265_644# 0.18fF
C103 a_390_588# a_410_556# 0.05fF
C104 vdd a_251_357# 0.09fF
C105 a_171_125# B0 0.01fF
C106 a_212_32# G0 0.09fF
C107 B1 w_206_245# 0.08fF
C108 a_264_283# w_294_255# 0.08fF
C109 a_71_544# vdd 0.13fF
C110 vdd a_71_160# 0.13fF
C111 P2 a_251_357# 0.05fF
C112 w_263_0# a_288_44# 0.09fF
C113 a_119_160# B1 0.00fF
C114 C4 a_378_556# 0.08fF
C115 gnd a_19_472# 0.29fF
C116 P1 a_281_160# 0.12fF
C117 C1 gnd 0.16fF
C118 a_149_93# B0 0.00fF
C119 P3P2 P3G2+G3 0.83fF
C120 a_171_544# a_142_576# 0.02fF
C121 P0 G0 0.06fF
C122 B2 CLK 0.13fF
C123 a_71_544# B4 0.03fF
C124 a_119_79# CLK 0.36fF
C125 a_313_416# G3 0.07fF
C126 a_219_123# vdd 0.03fF
C127 P4 gnd 0.27fF
C128 a_142_192# vdd 0.14fF
C129 a_212_253# gnd 0.02fF
C130 gnd a_251_357# 0.02fF
C131 vdd CLK 1.30fF
C132 G4 a_323_641# 0.00fF
C133 G2 a_212_288# 0.09fF
C134 vdd B0in 0.10fF
C135 a_71_544# a_42_576# 0.02fF
C136 a_251_101# P0 0.05fF
C137 P2 a_264_294# 0.00fF
C138 w_206_629# vdd 0.43fF
C139 vdd a_406_348# 0.09fF
C140 a_315_160# a_281_160# 0.09fF
C141 A1 B1 0.39fF
C142 P1 a_312_101# 0.01fF
C143 C2 a_283_347# 0.06fF
C144 a_390_588# P4 0.02fF
C145 A2in B2 0.03fF
C146 B4 CLK 0.13fF
C147 CLK B3 0.13fF
C148 a_314_544# vdd 0.14fF
C149 a_42_93# a_71_125# 0.02fF
C150 A2in vdd 0.09fF
C151 a_339_210# G1 0.24fF
C152 B4 w_206_629# 0.08fF
C153 a_42_576# CLK 0.10fF
C154 B4in vdd 0.10fF
C155 CLK gnd 2.78fF
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
C322 A2in CLK 0.10fF
C323 a_219_475# A3 0.04fF
C324 a_251_546# gnd 0.02fF
C325 a_251_418# gnd 0.02fF
C326 a_219_162# vdd 0.03fF
C327 B4in CLK 0.10fF
C328 a_323_641# a_323_619# 0.00fF
C329 gnd A2 0.15fF
C330 vdd a_19_600# 0.03fF
C331 B3 a_212_509# 0.12fF
C332 vdd a_278_125# 0.18fF
C333 vdd A3in 0.09fF
C334 a_315_160# vdd 0.14fF
C335 a_142_349# a_171_381# 0.02fF
C336 P1 gnd 0.13fF
C337 C4 a_272_609# 0.03fF
C338 gnd a_212_509# 0.02fF
C339 a_279_416# vdd 0.18fF
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
